craigyjp/Poly-Zero-8-voice-Polysynth/Photos/20240305_211138.jpg

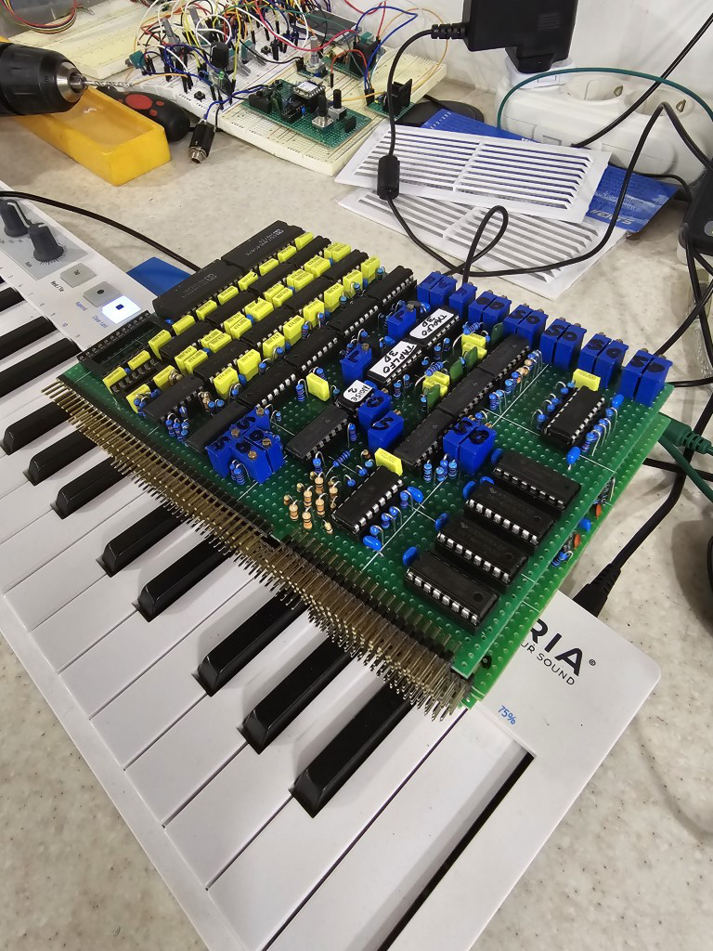
Photos/20240305_211138.jpg
