craigyjp/Poly-Zero-8-voice-Polysynth/Photos/20240305_211143.jpg

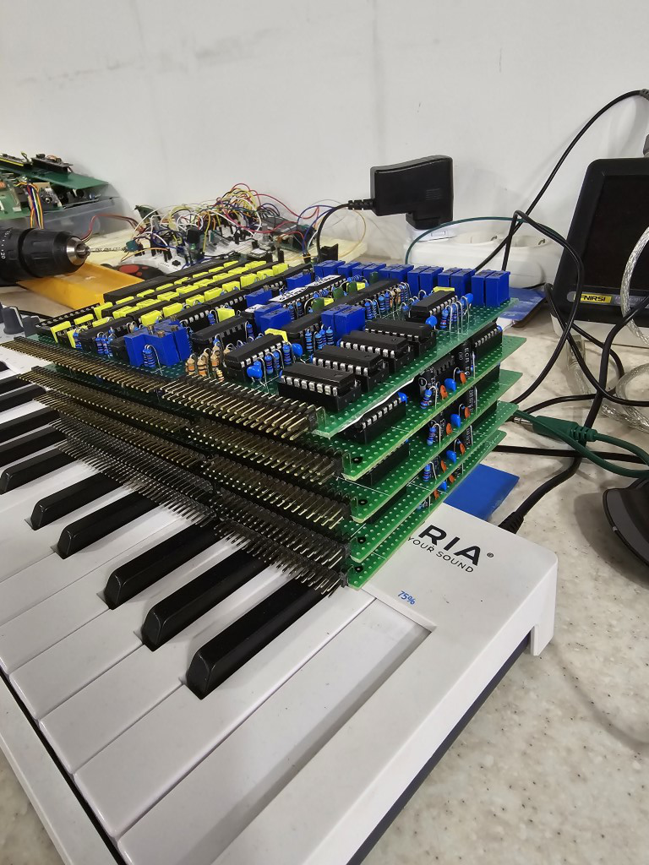
Photos/20240305_211143.jpg
