craigyjp/Poly-Zero-8-voice-Polysynth/Photos/20240305_211212.jpg

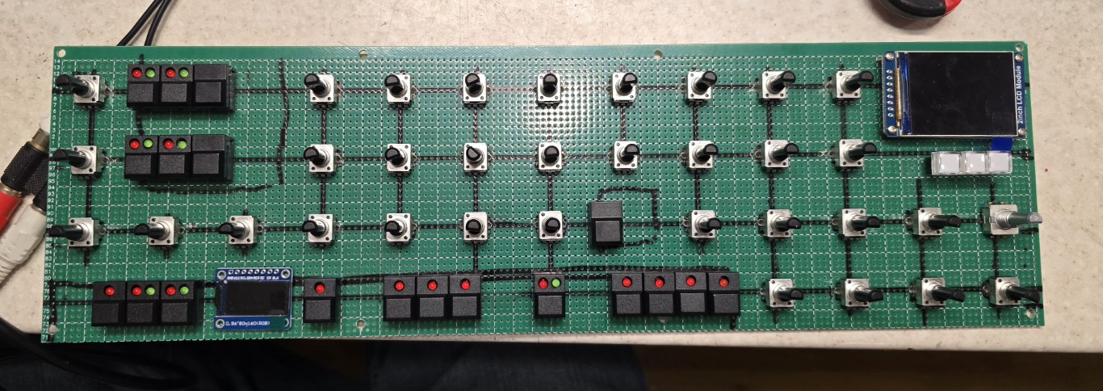
Photos/20240305_211212.jpg
