craigyjp/Poly-Zero-8-voice-Polysynth/Photos/20240306_220125.jpg

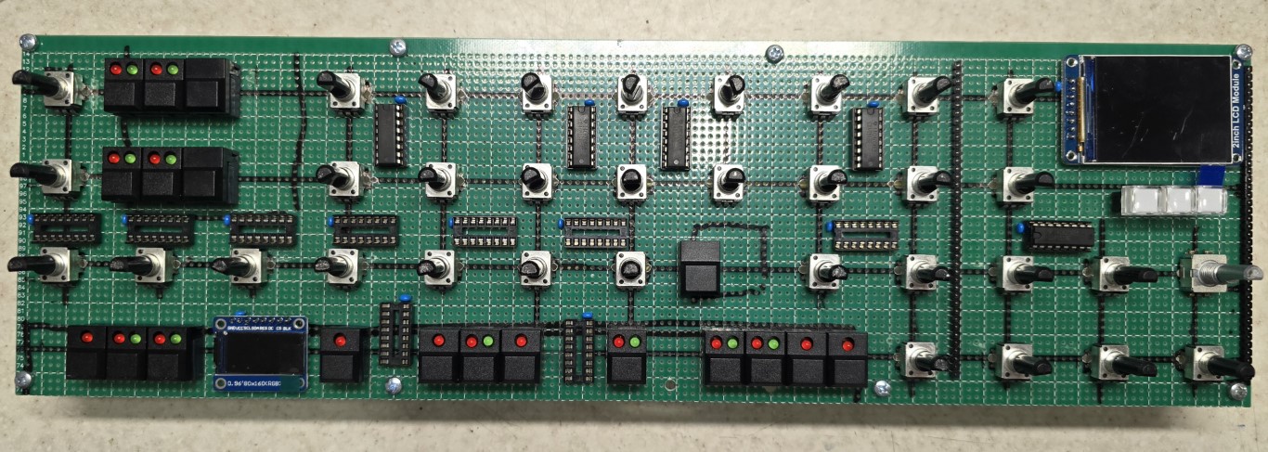
Photos/20240306_220125.jpg
