craigyjp/Poly-Zero-8-voice-Polysynth/Photos/20240310_184923.jpg

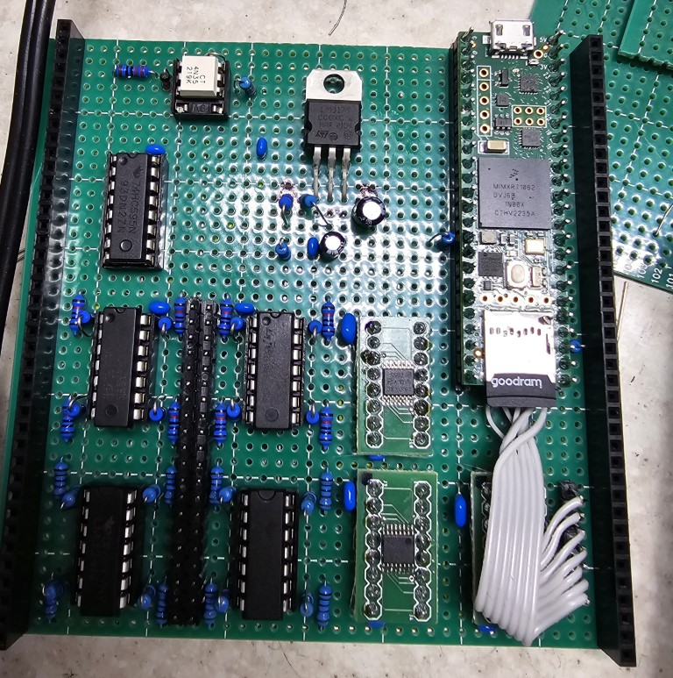
Photos/20240310_184923.jpg
