craigyjp/Poly-Zero-8-voice-Polysynth/Photos/20240310_185404.jpg

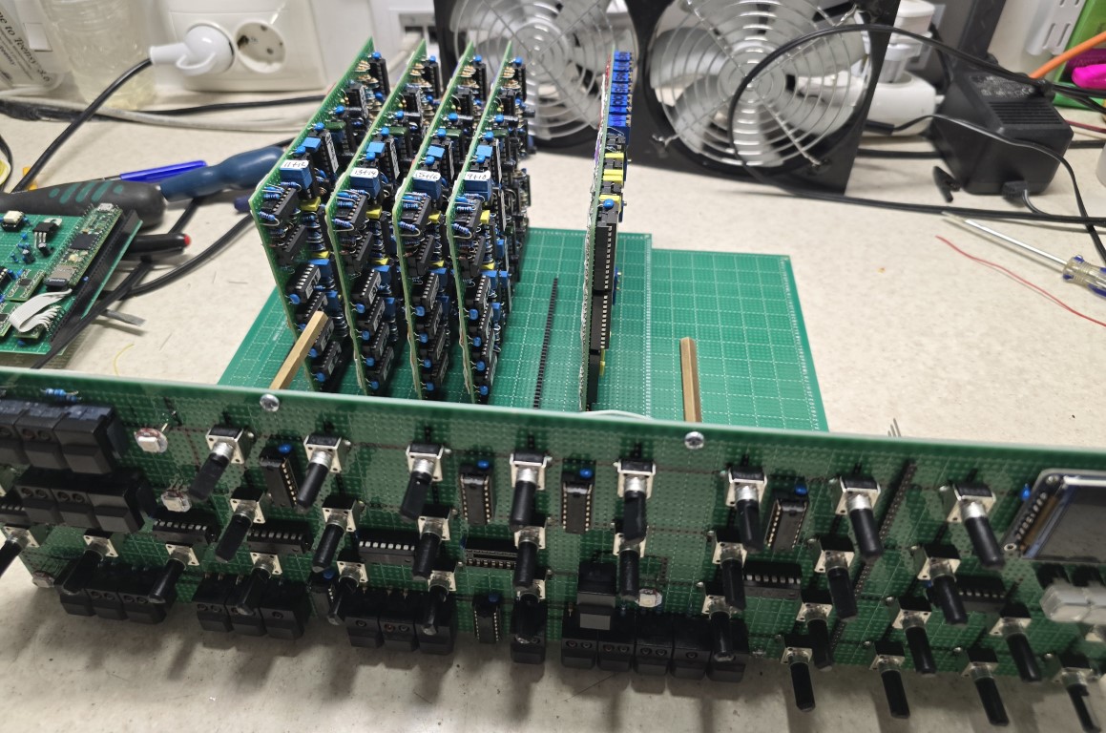
Photos/20240310_185404.jpg
