craigyjp/Poly-Zero-8-voice-Polysynth/Photos/20240312_125551.jpg

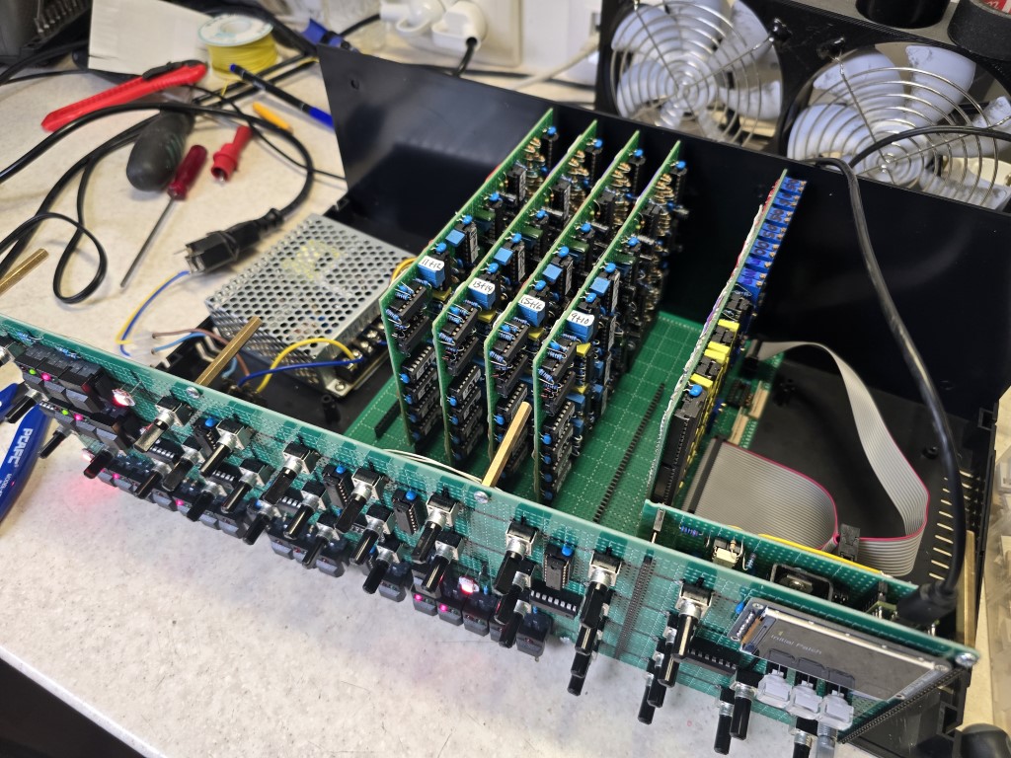
Photos/20240312_125551.jpg
