craigyjp/Poly-Zero-8-voice-Polysynth/Photos/20240313_165845.jpg

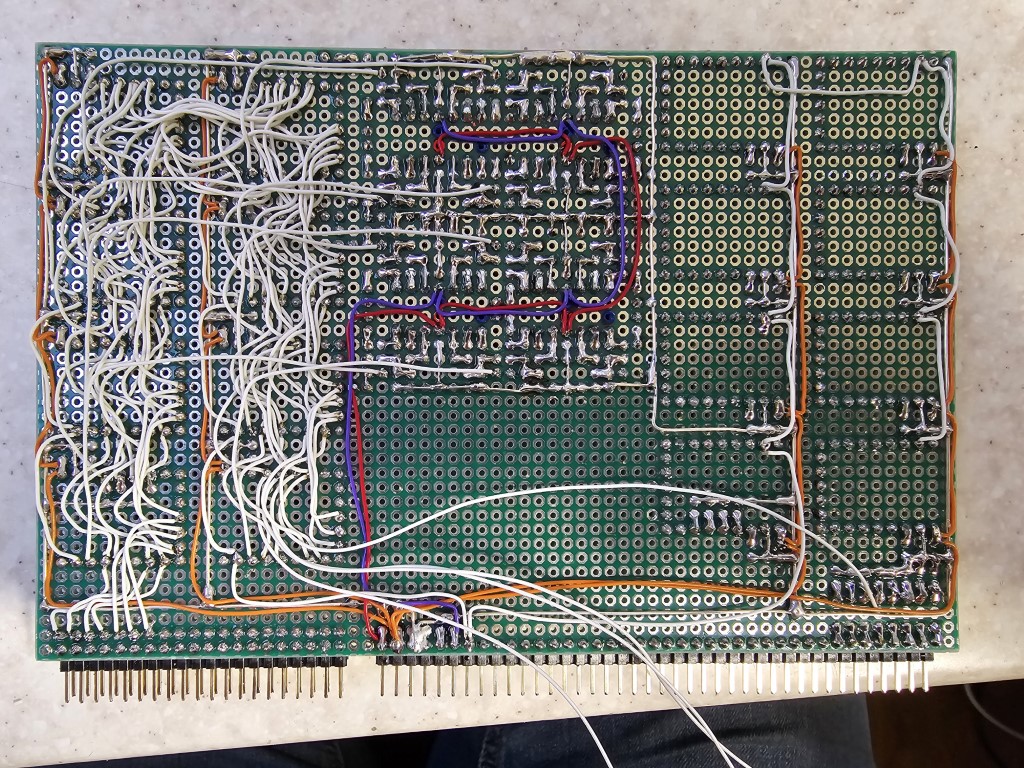
Photos/20240313_165845.jpg
