craigyjp/Poly-Zero-8-voice-Polysynth/Photos/20240313_225103.jpg

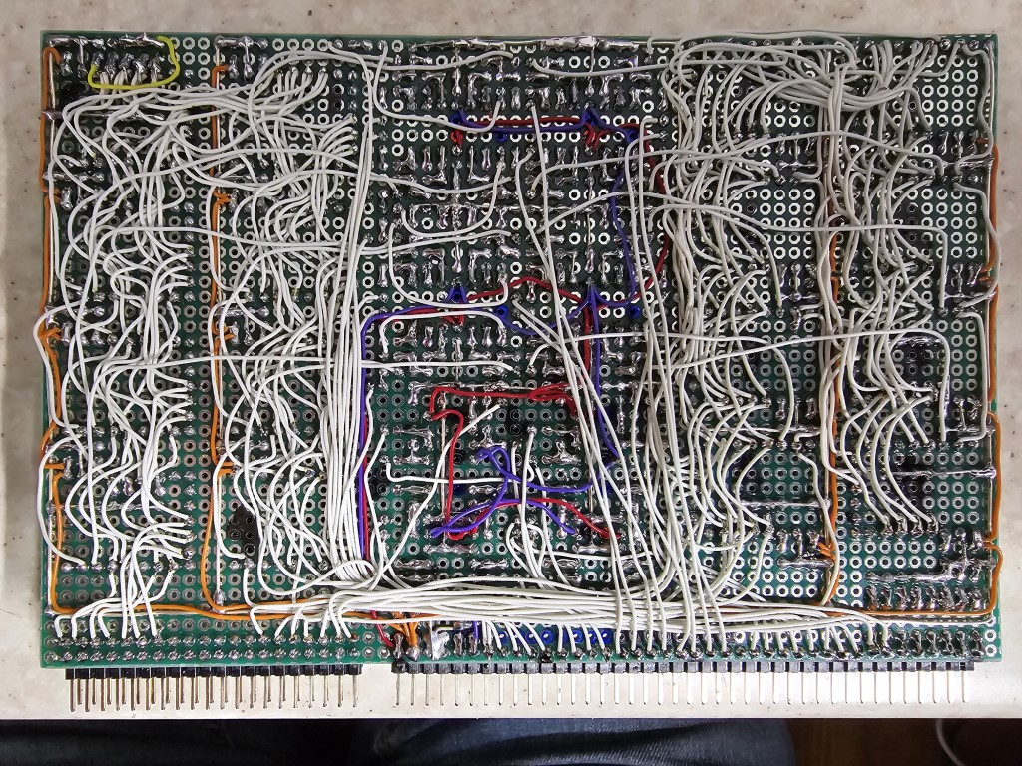
Photos/20240313_225103.jpg
