craigyjp/Poly-Zero-8-voice-Polysynth/Photos/20240326_214050.jpg

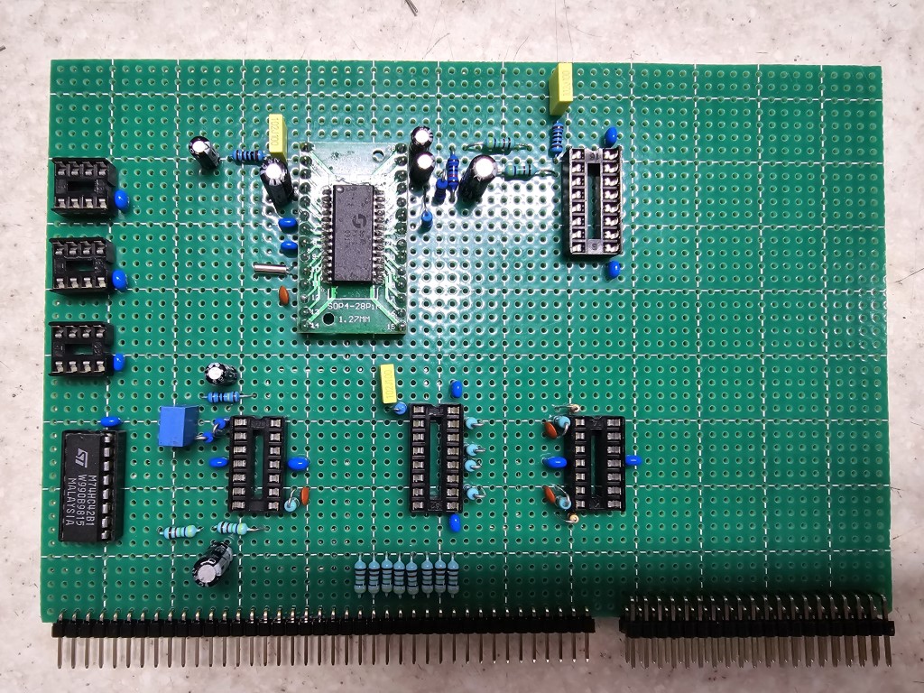
Photos/20240326_214050.jpg
