craigyjp/Poly-Zero-8-voice-Polysynth/Photos/20240331_192204.jpg

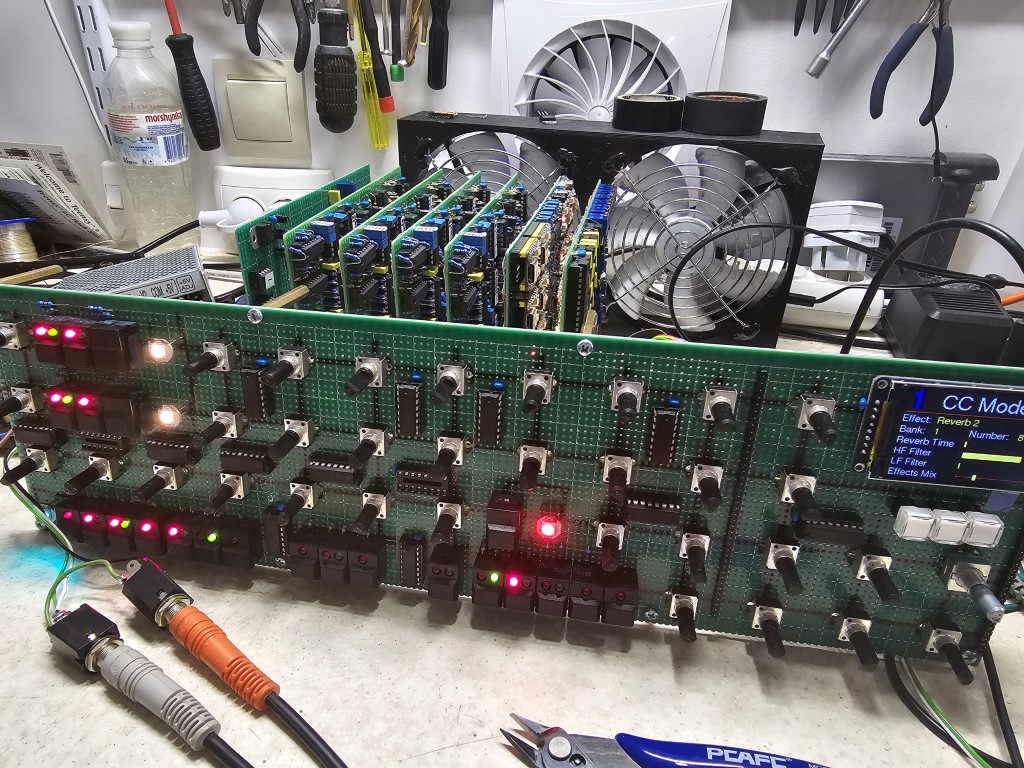
Photos/20240331_192204.jpg
