craigyjp/Poly-Zero-8-voice-Polysynth/Photos/20240331_193349.jpg

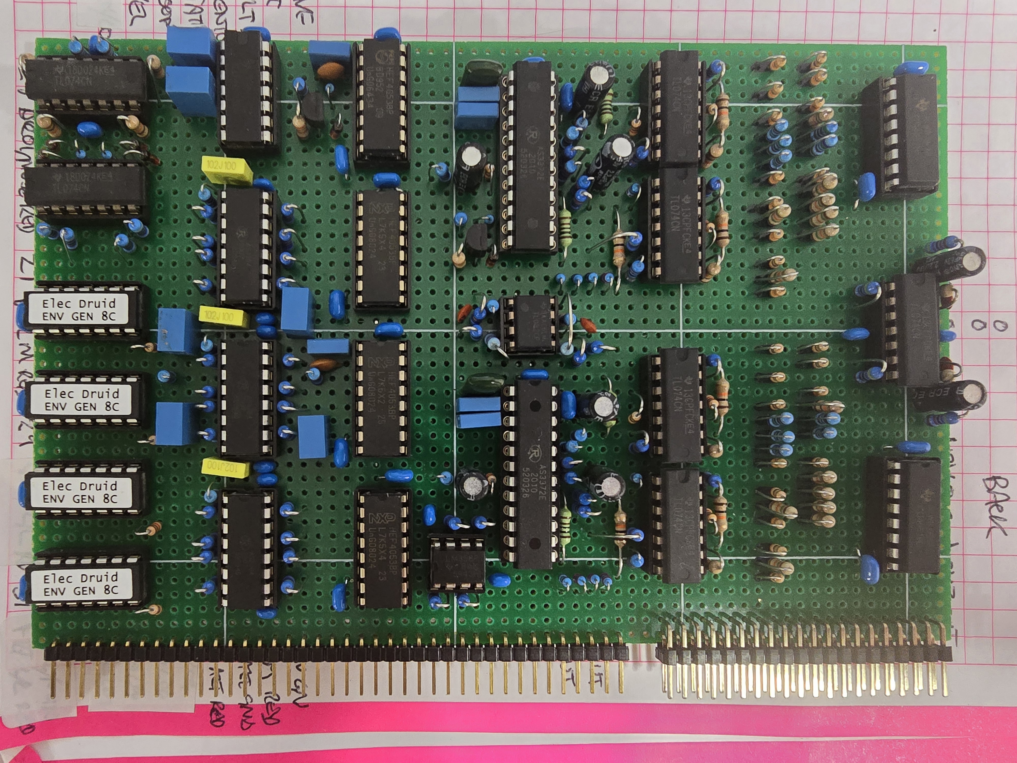
Photos/20240331_193349.jpg
