craigyjp/Poly-Zero-8-voice-Polysynth/Photos/20240331_193359.jpg

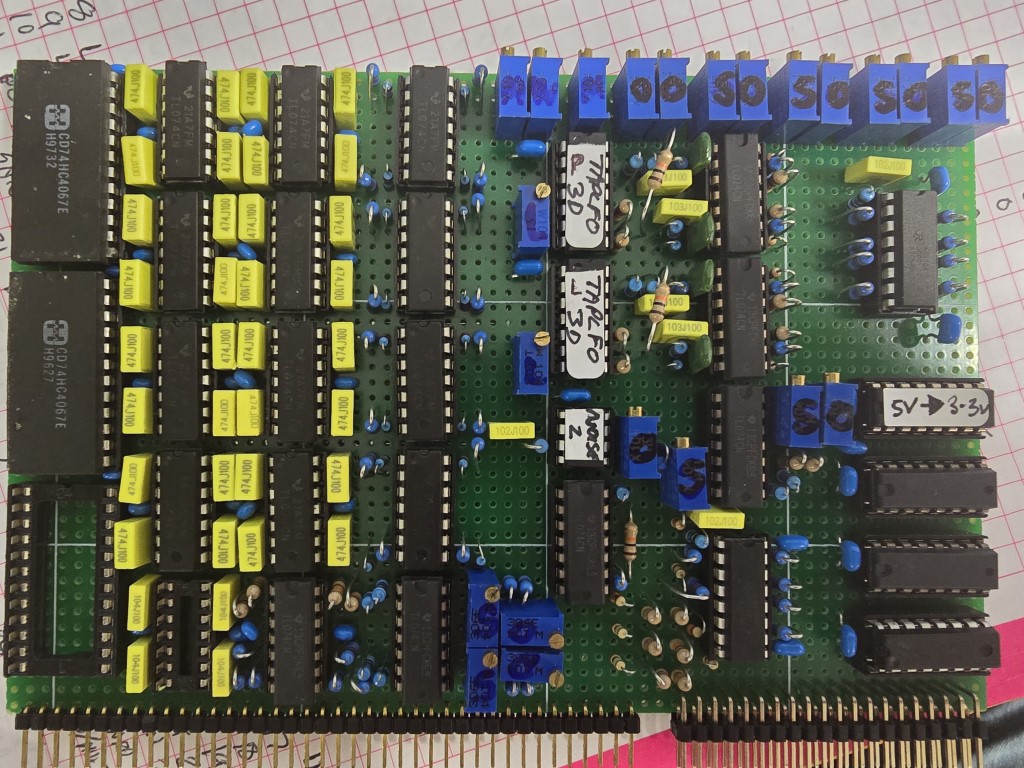
Photos/20240331_193359.jpg
