craigyjp/Poly-Zero-8-voice-Polysynth/Photos/synth2.jpg

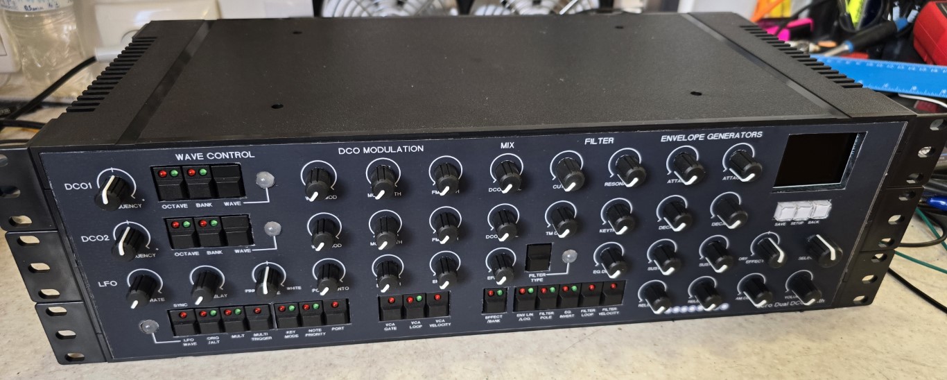
Photos/synth2.jpg
