craigyjp/Poly-Zero-8-voice-Polysynth/(threads)

Thread 1 (2024-05-25):

More pictures and PCB available?

spotlesscoder, 2024-05-25:
Hi,

do you have more pictures of the inner life of the device?
Looks really promising - I would love to build one for myself - do you have gerber files for the PCB(s) inside?

craigyjp, 2024-05-25:
Hi, I don't have gerbers because it's on proto boards and not PCB's, all hand wired for the 7 cards and the mother board.

craigyjp, 2024-05-25:
I've just added some photos

craigyjp, 2024-05-25:
I hope thats enough info

spotlesscoder, 2024-05-25:
Holy hell that must have been a lot of work :O

Thanks for sharing this, loving it :)

Closed 2024-05-25.
