craigyjp/Poly-Zero-8-voice-Polysynth/Schematics/Zero_DCO_Board.pdf

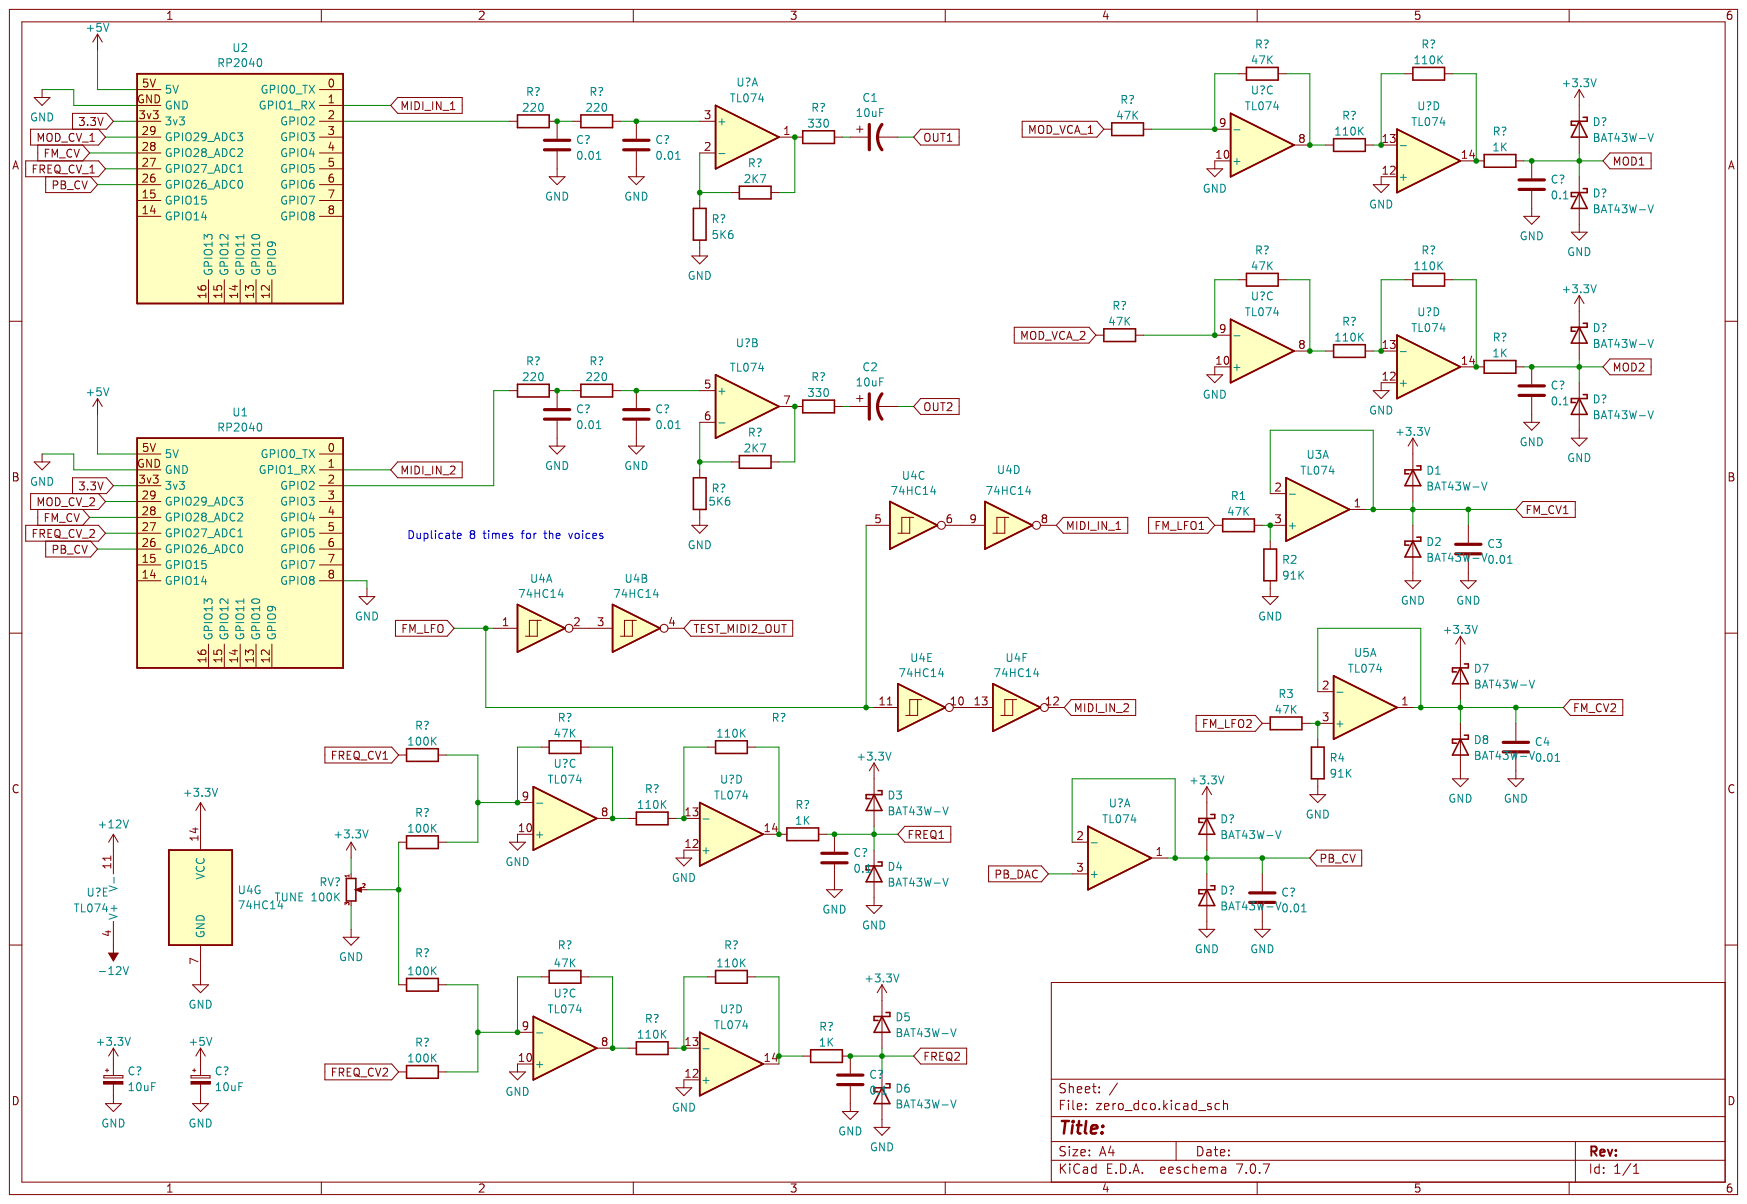
[picture p17: page 1]
