craigyjp/Poly-Zero-8-voice-Polysynth/Schematics/DAC_Demux.pdf

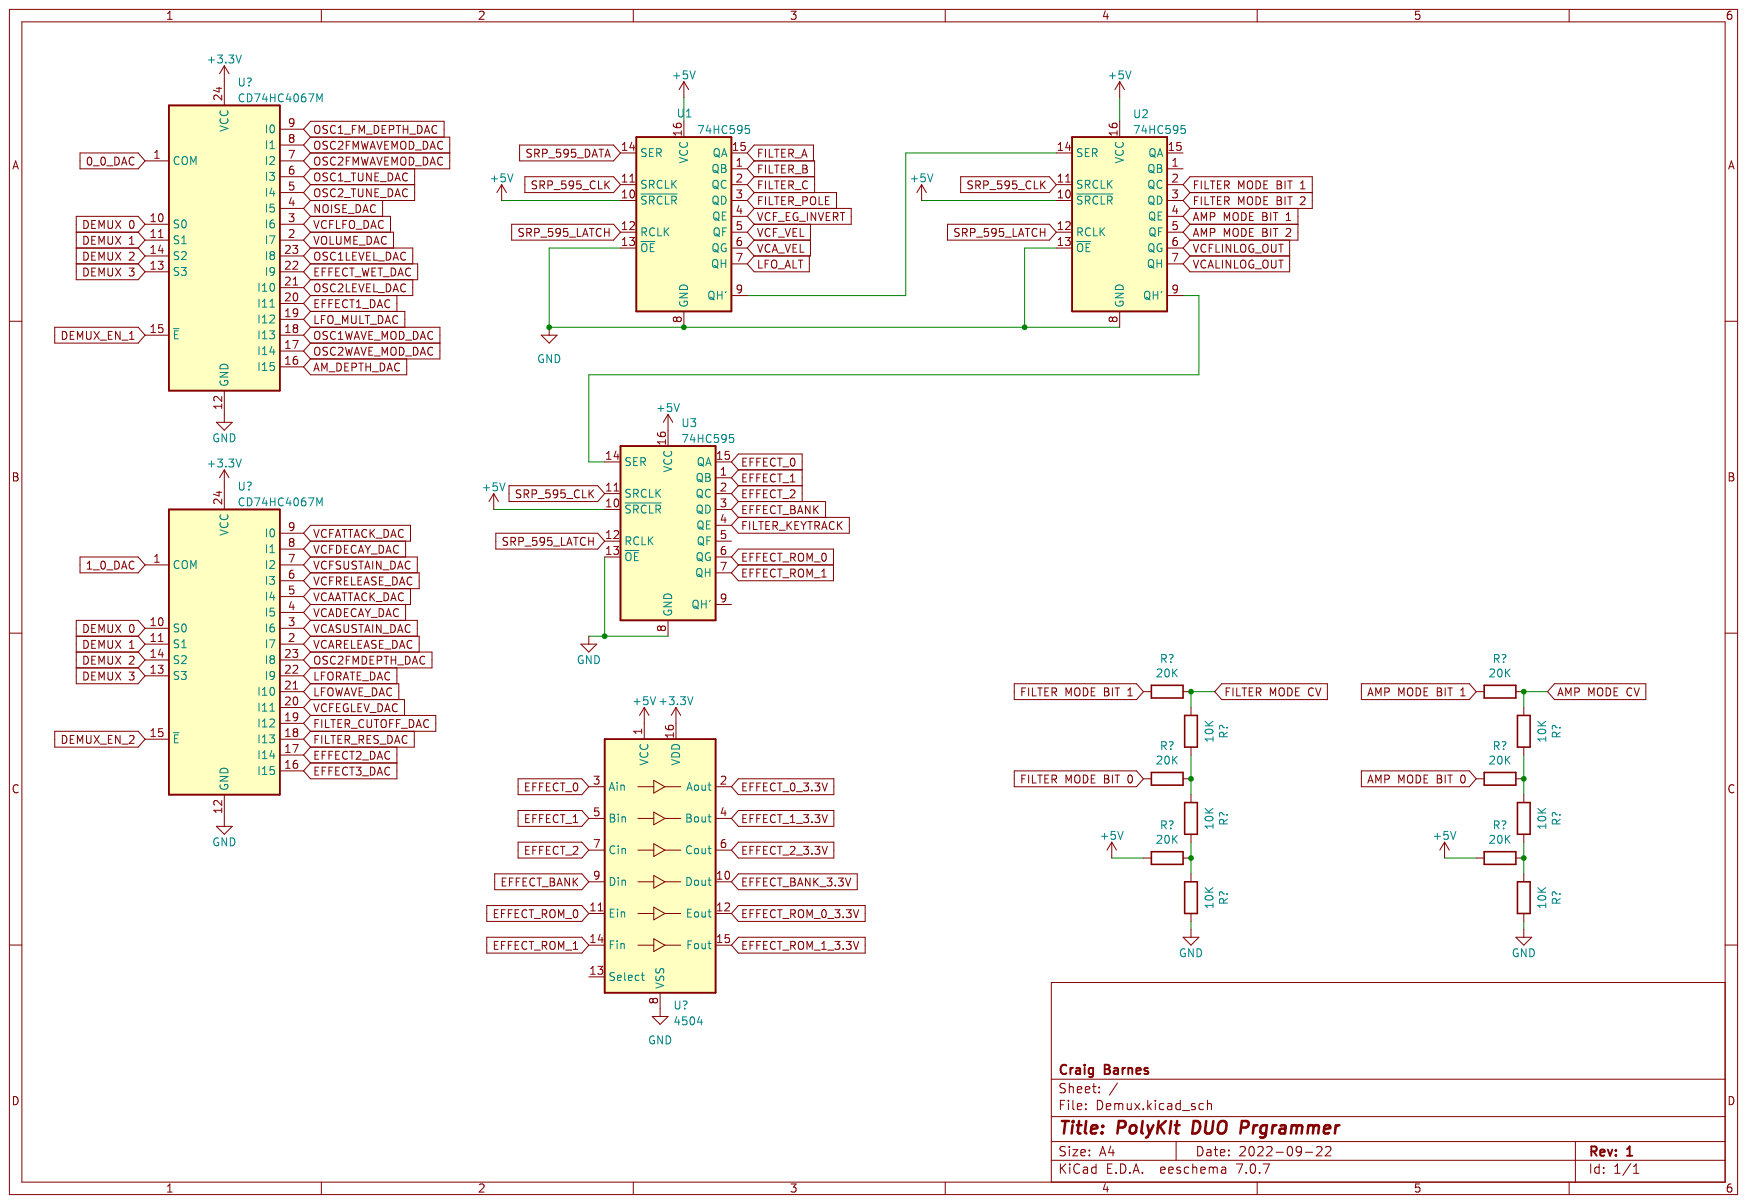
[picture p18: page 1]
