craigyjp/Poly-Zero-8-voice-Polysynth/Schematics/Effects_Board.pdf

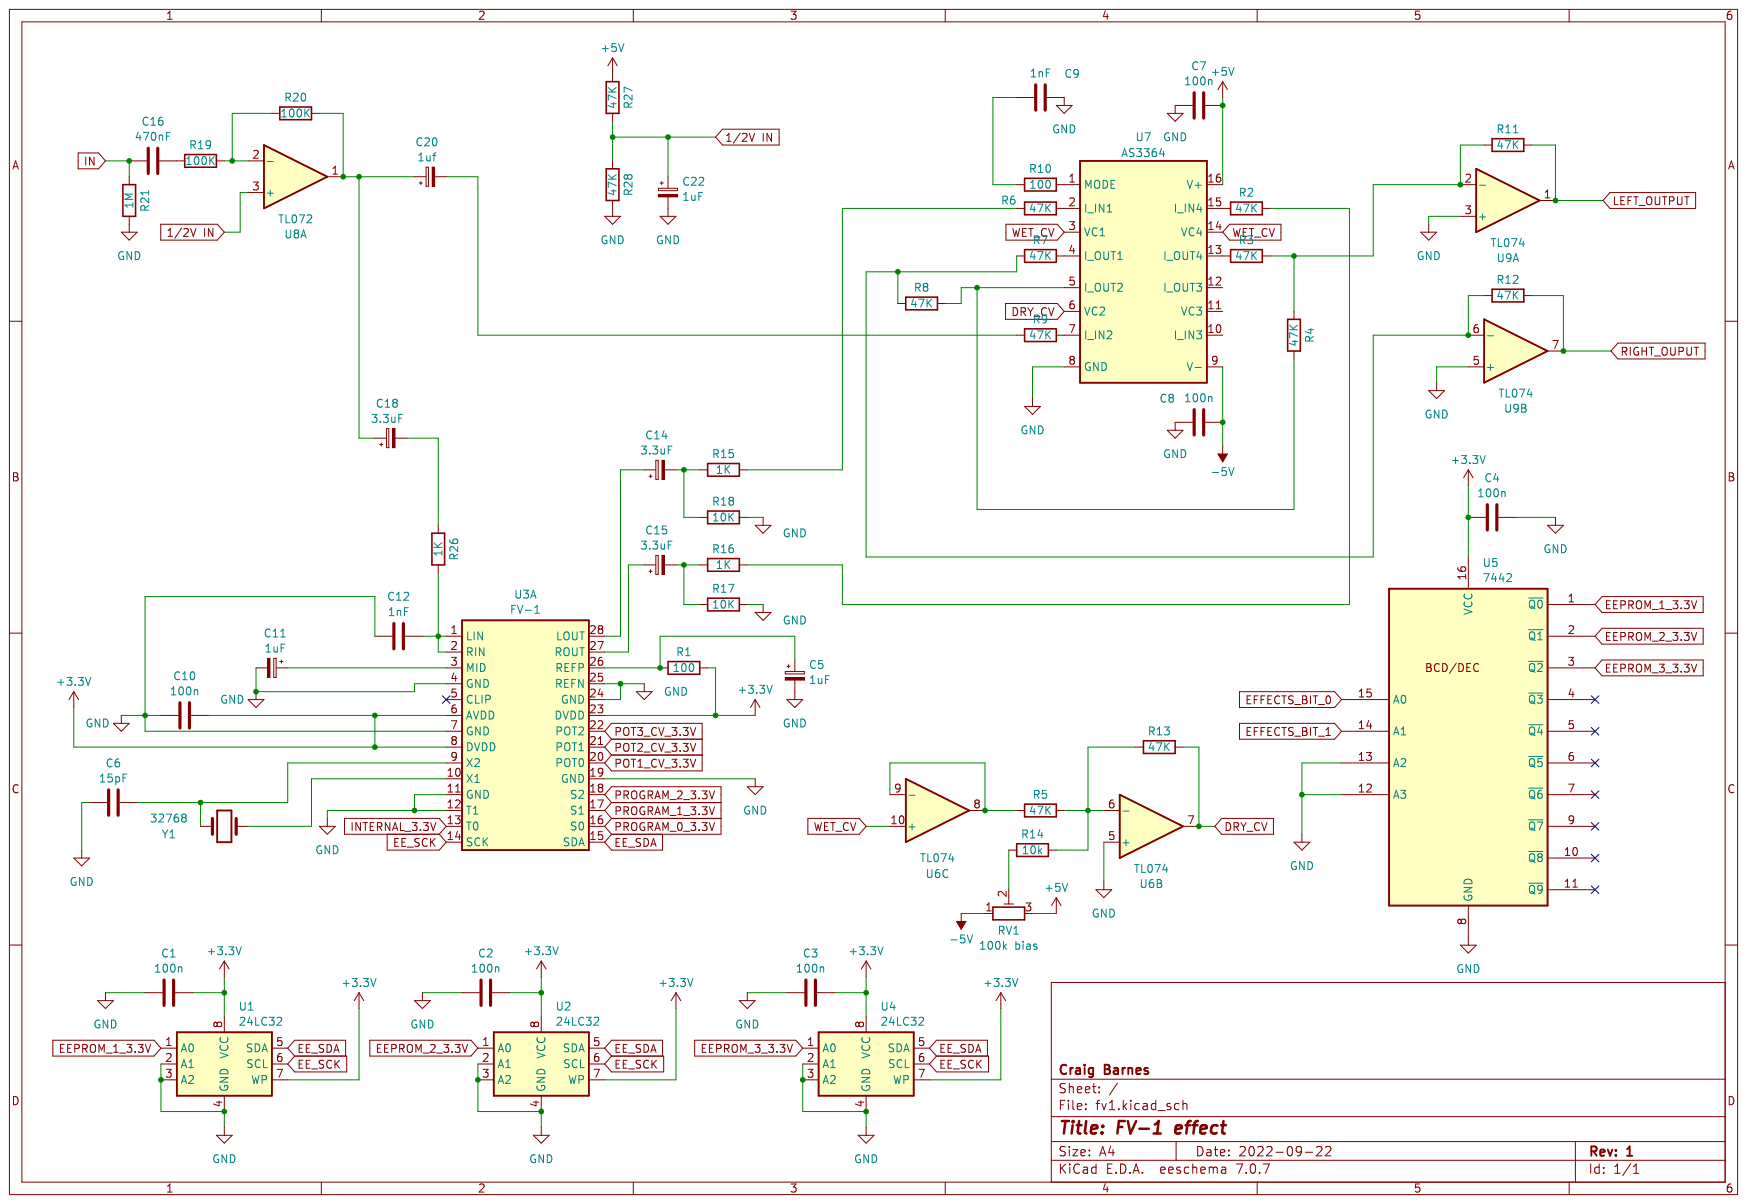
[picture p19: page 1]
