craigyjp/Poly-Zero-8-voice-Polysynth/Schematics/Final_VCA.pdf

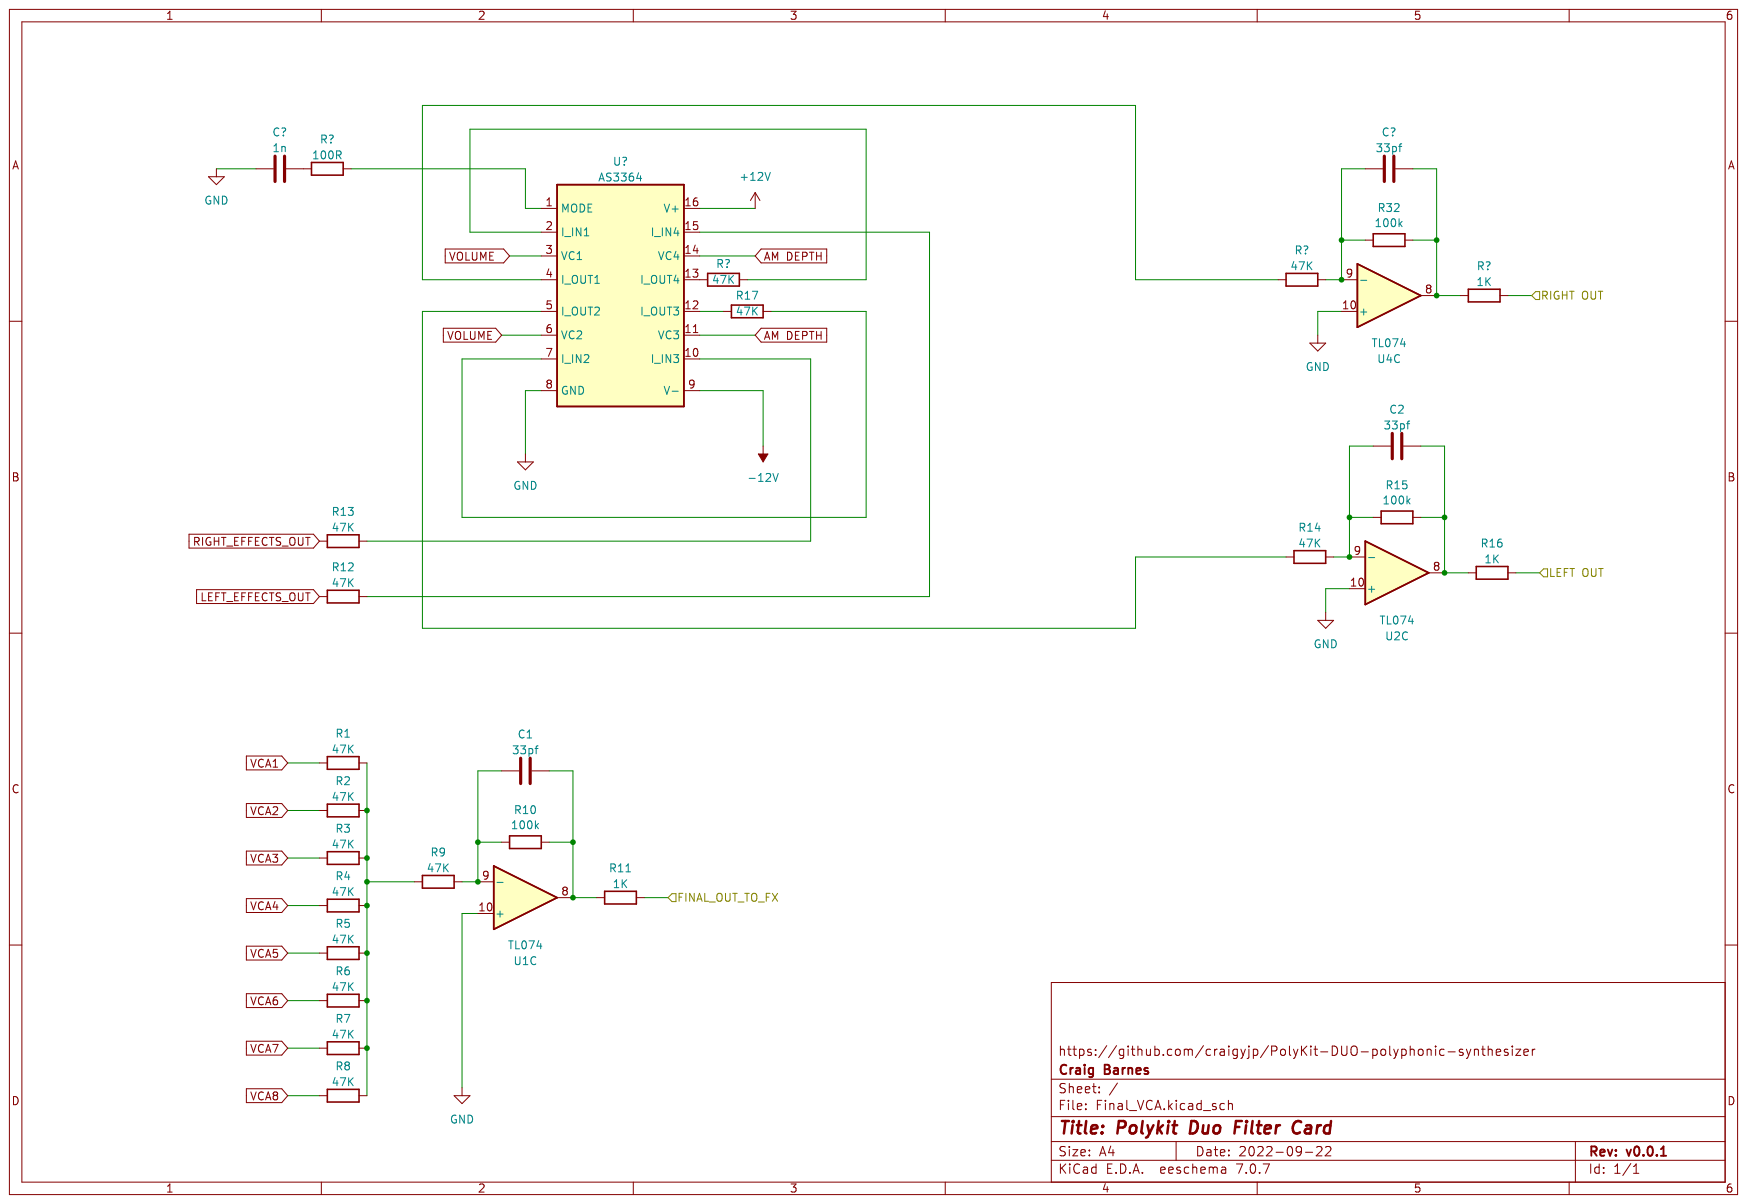
[picture p20: page 1]
