craigyjp/Poly-Zero-8-voice-Polysynth/Schematics/FrontPanel_pots.pdf

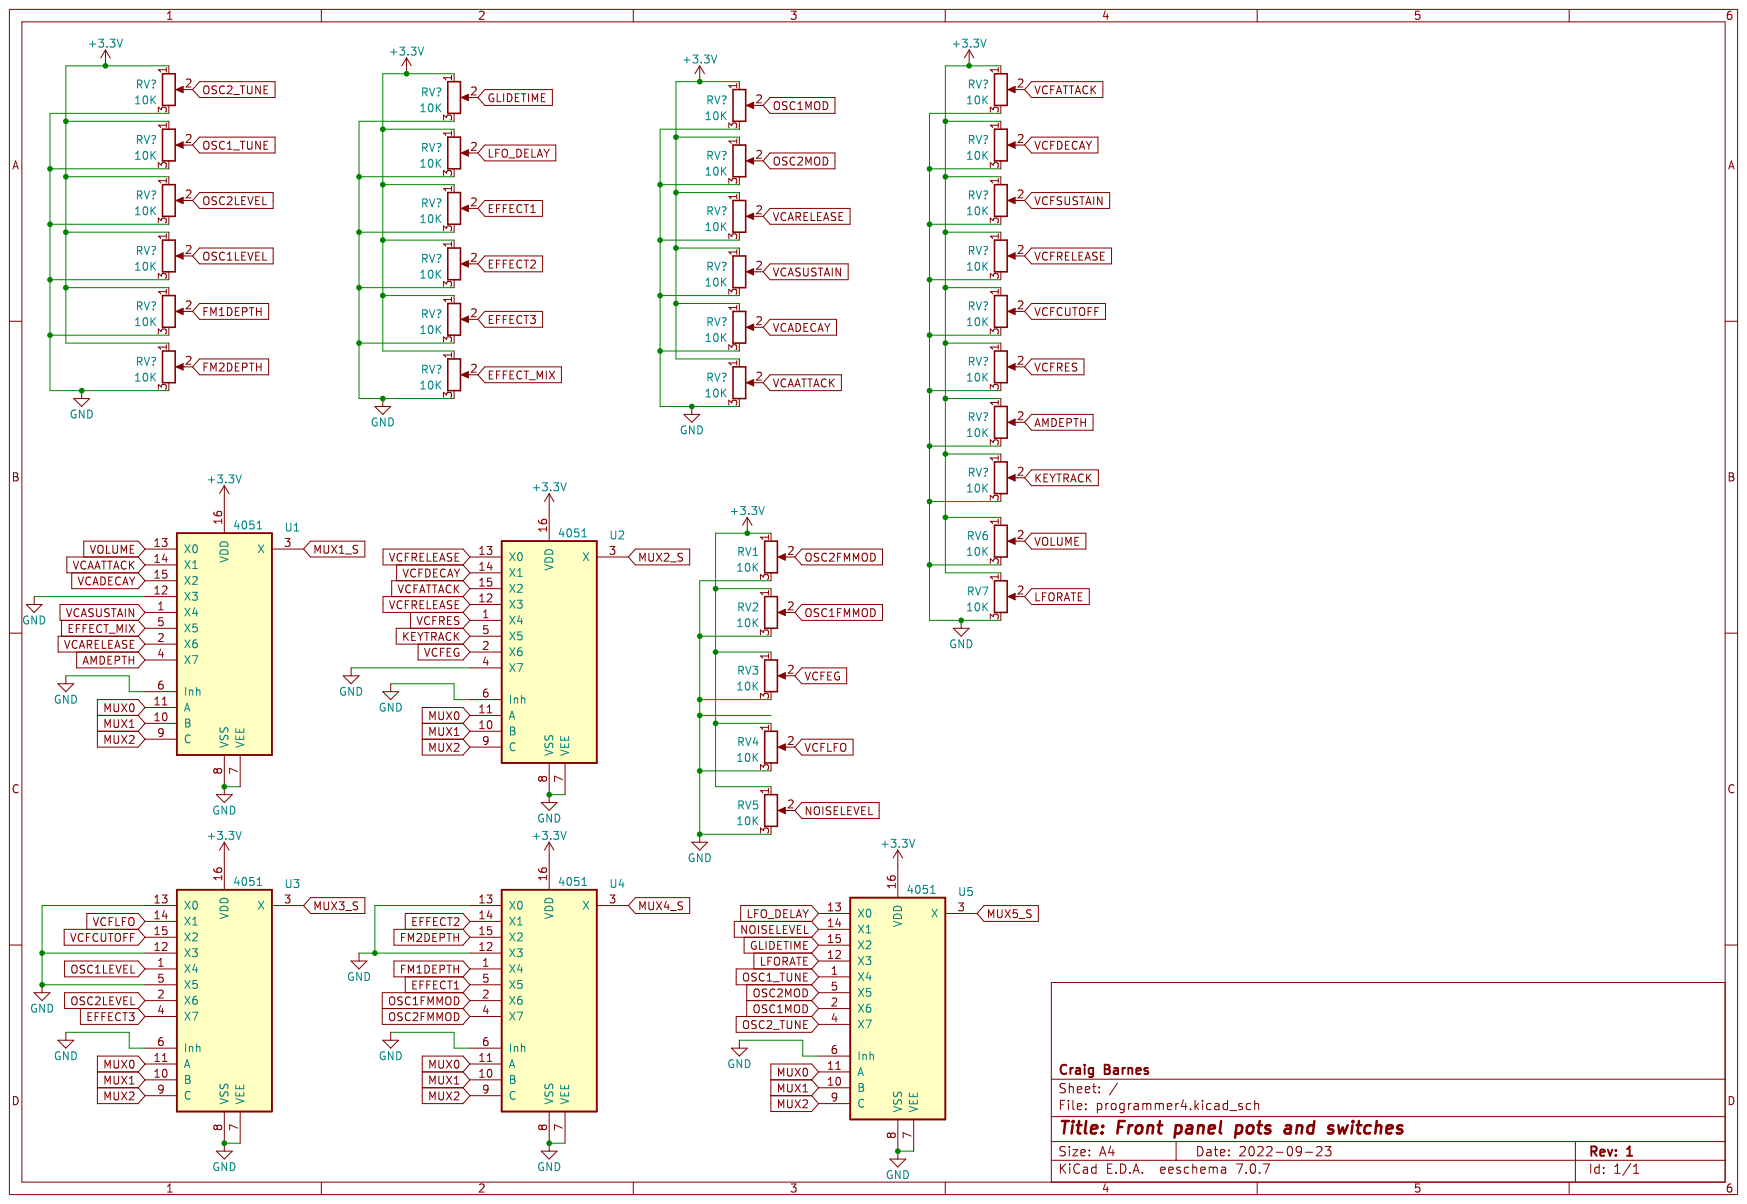
[picture p21: page 1]
