craigyjp/Poly-Zero-8-voice-Polysynth/Schematics/FrontPanelButtons.pdf

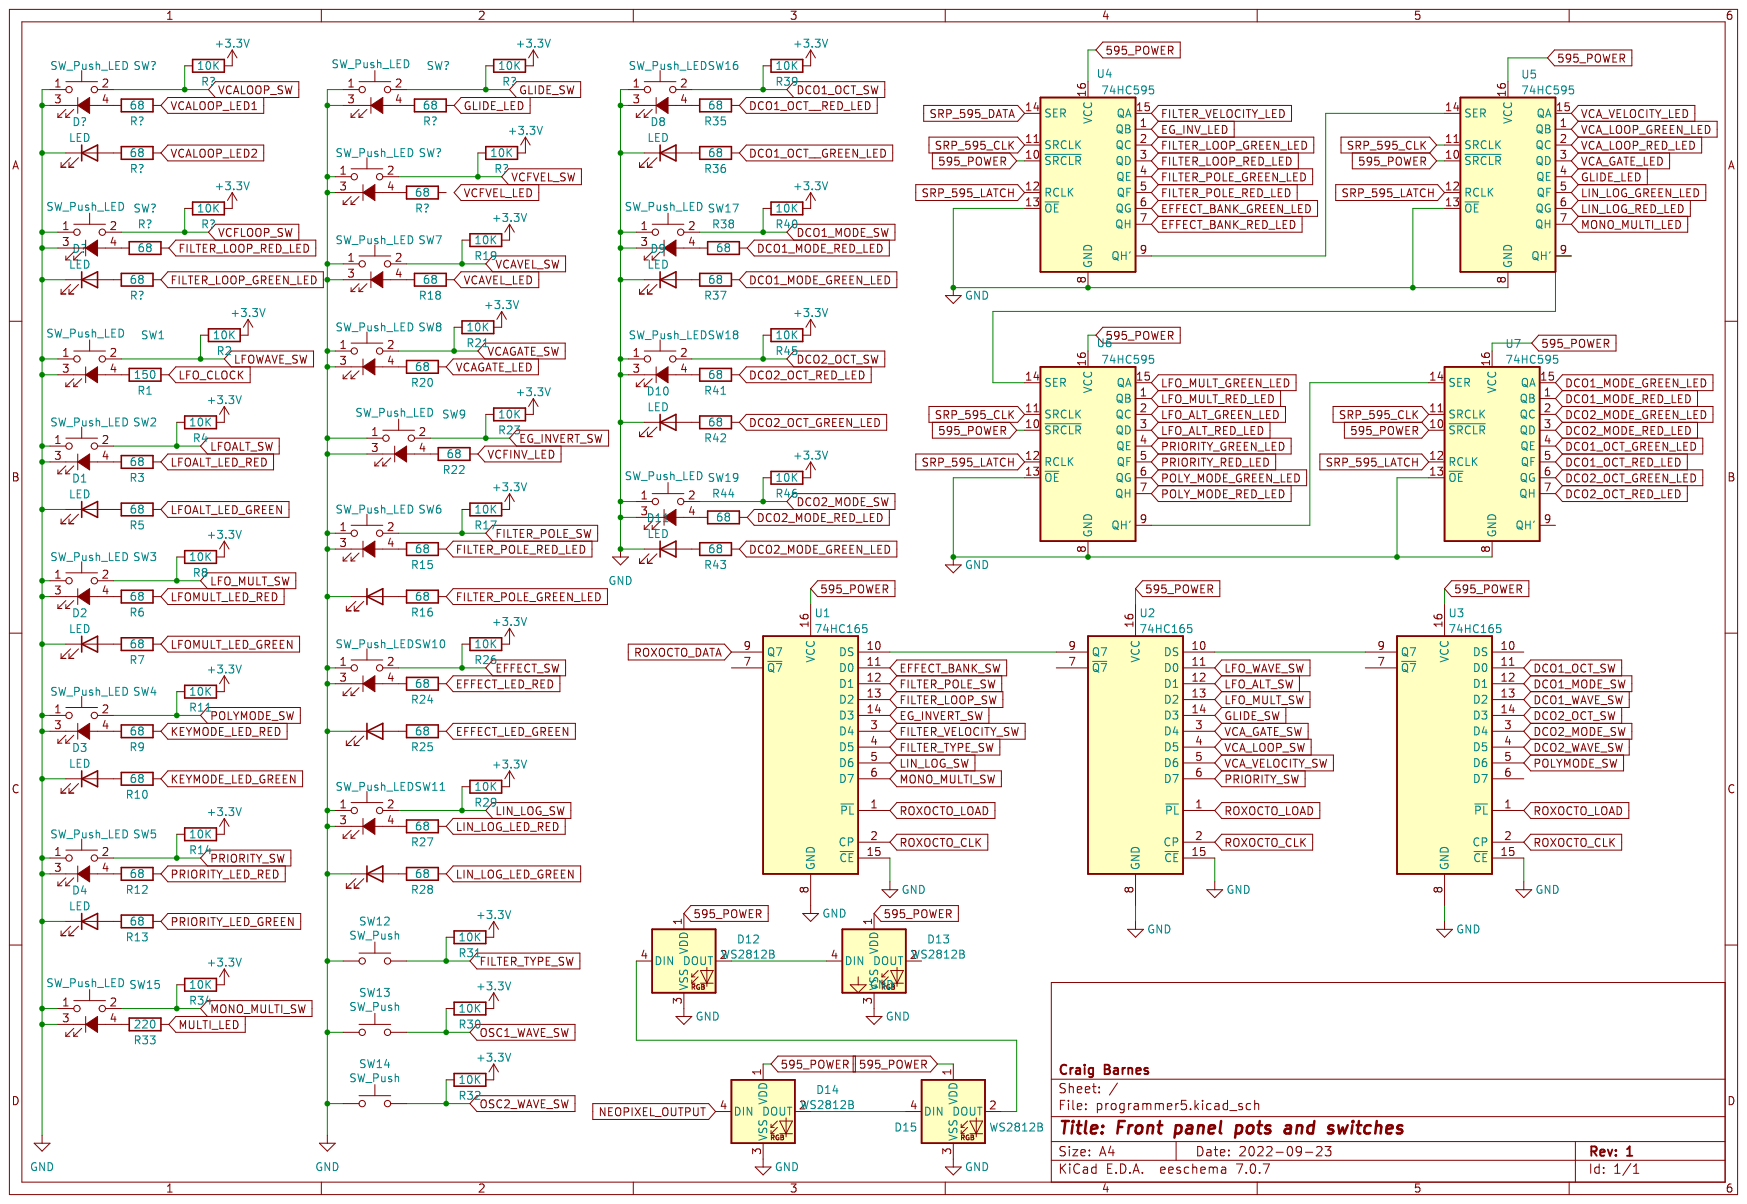
[picture p22: page 1]
