craigyjp/Poly-Zero-8-voice-Polysynth/Schematics/Level_conversion.pdf

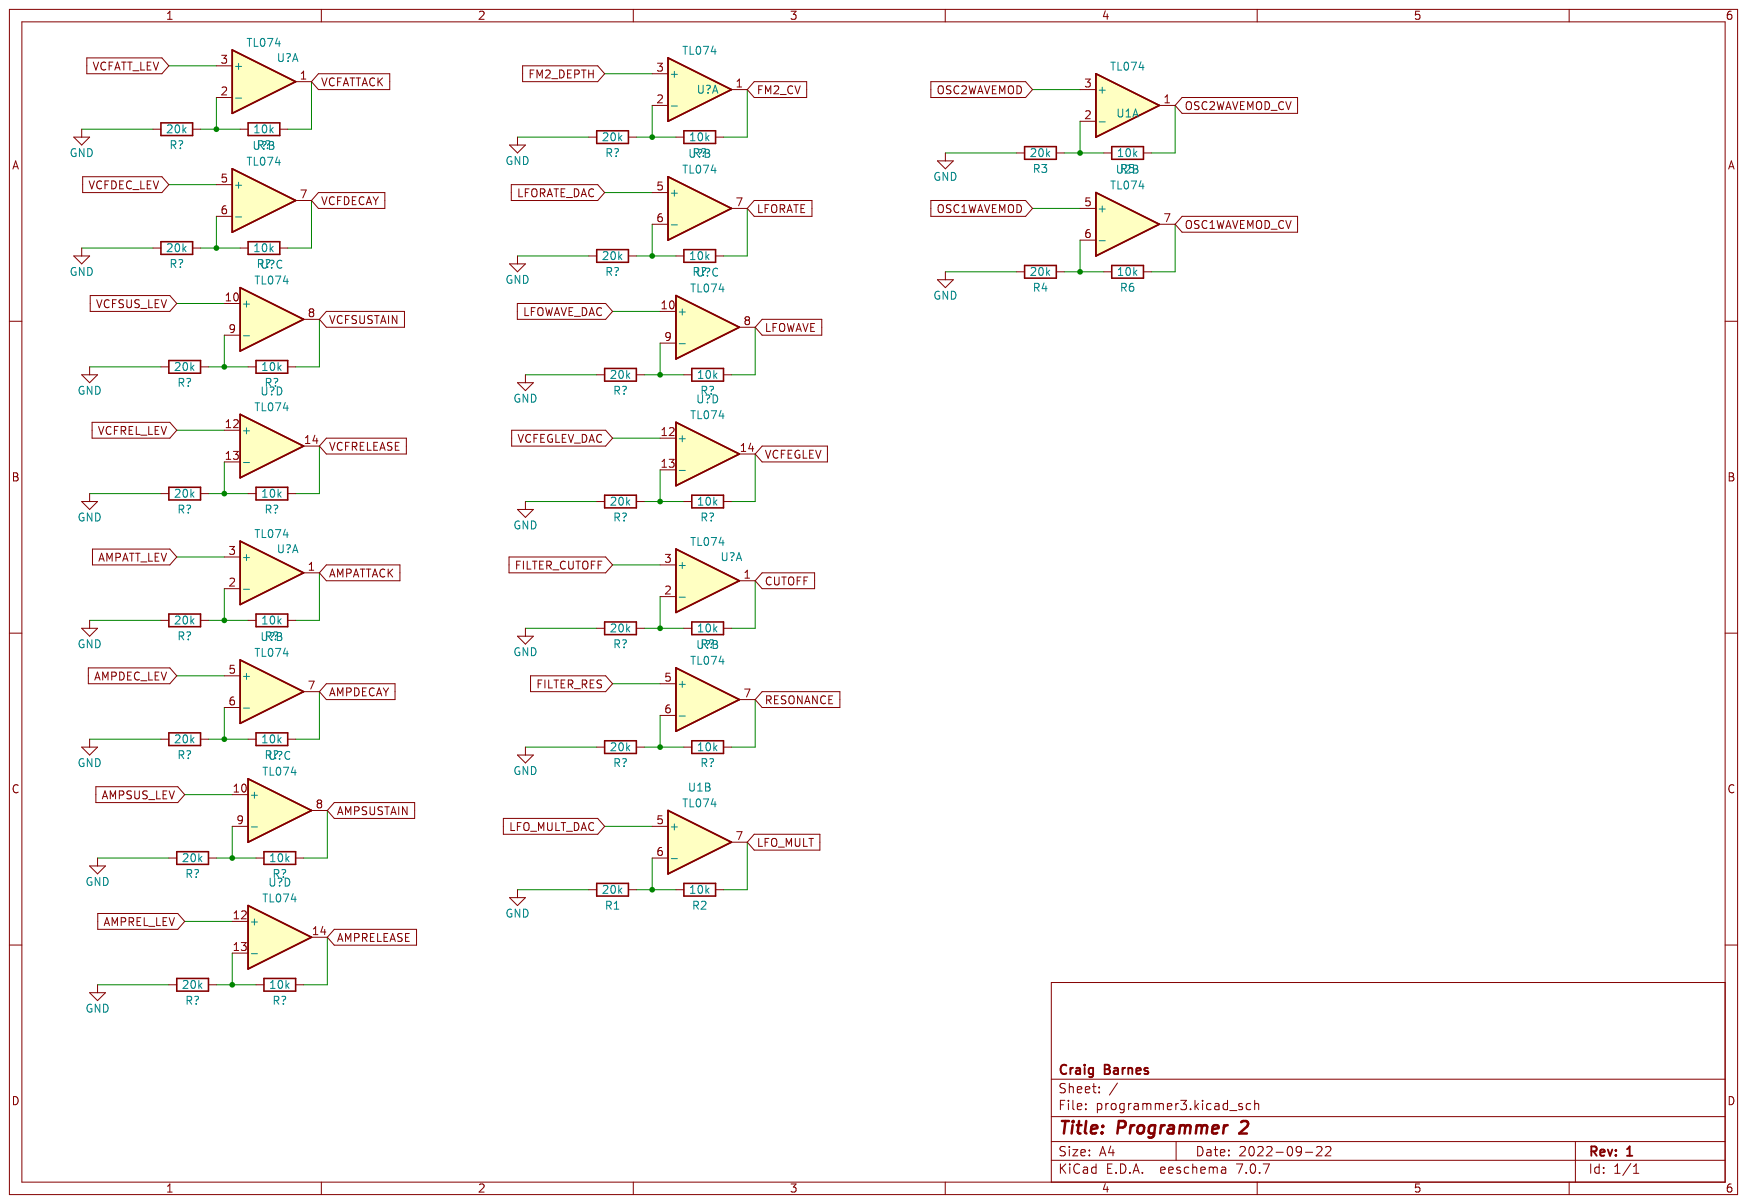
[picture p23: page 1]
