craigyjp/Poly-Zero-8-voice-Polysynth/Schematics/Sample_And_Hold.pdf

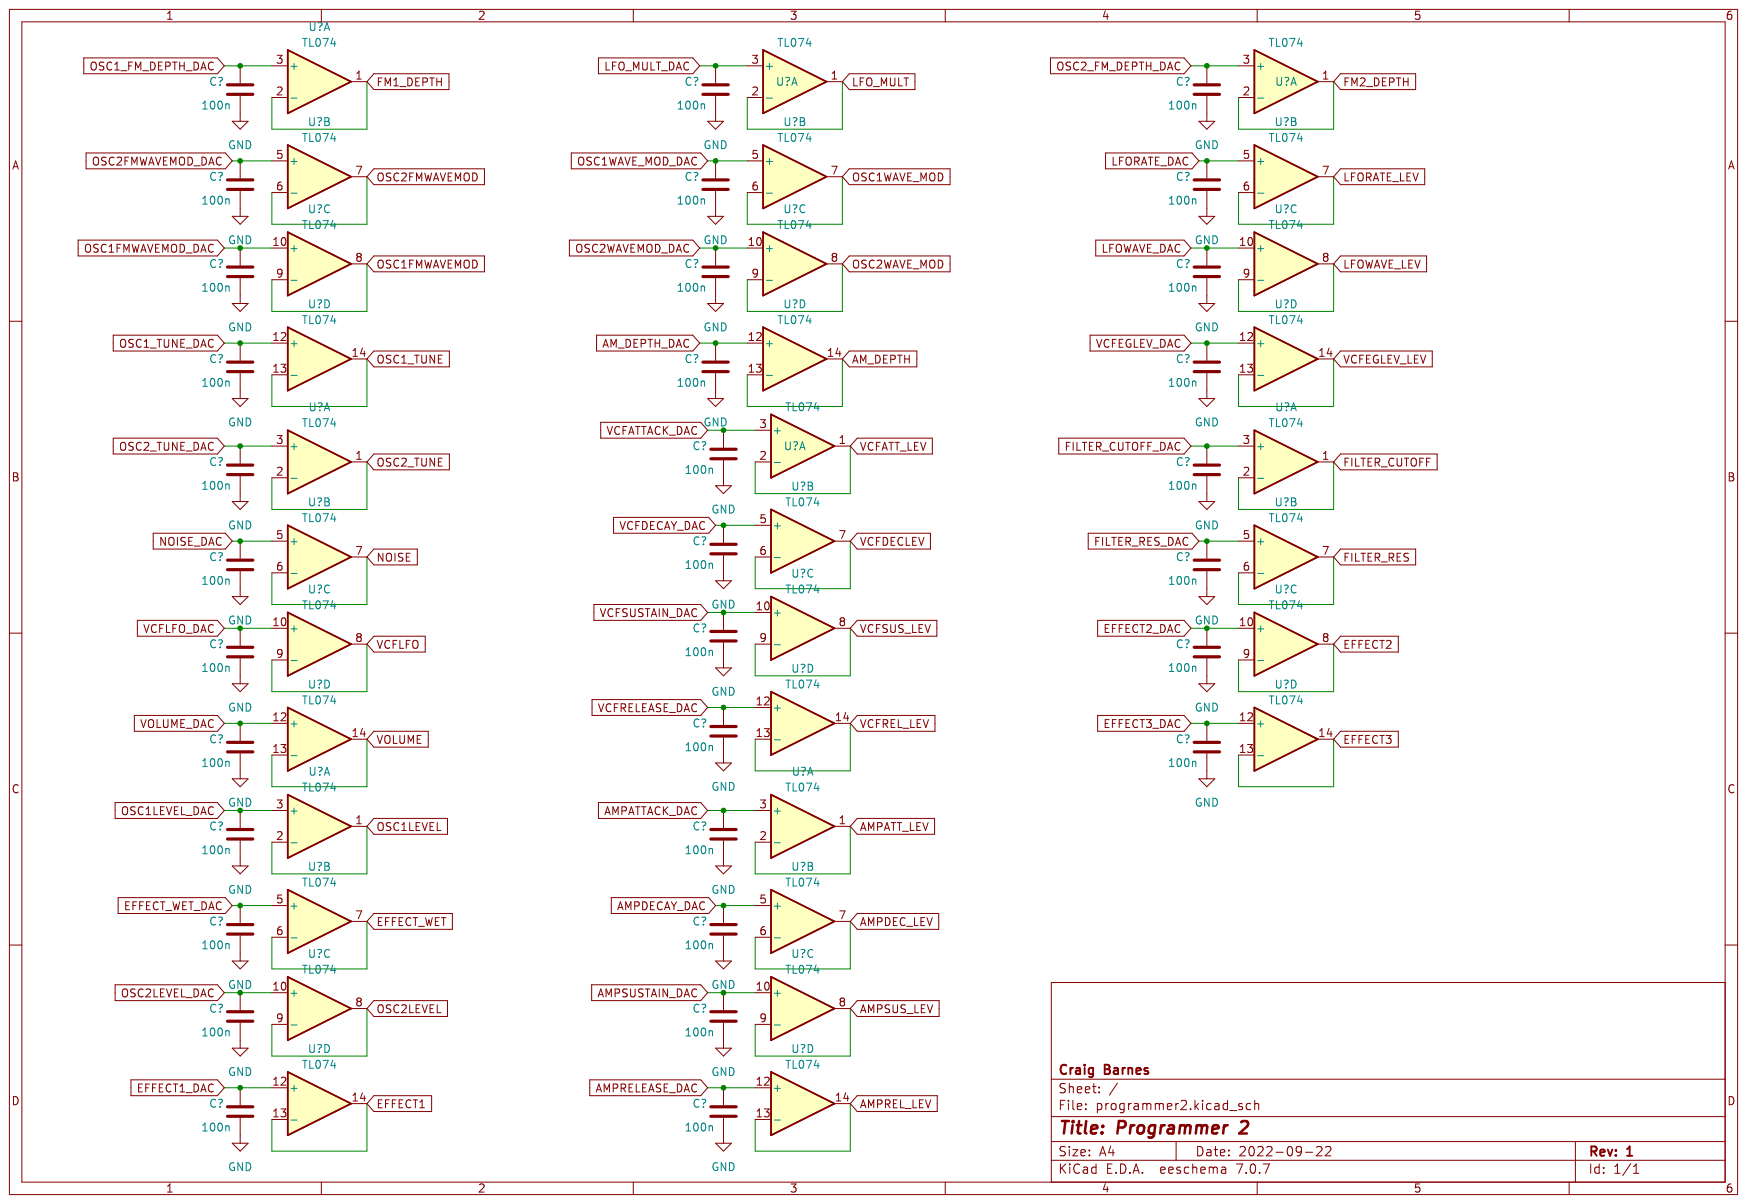
[picture p24: page 1]
