craigyjp/Poly-Zero-8-voice-Polysynth/Schematics/AS3372E.pdf

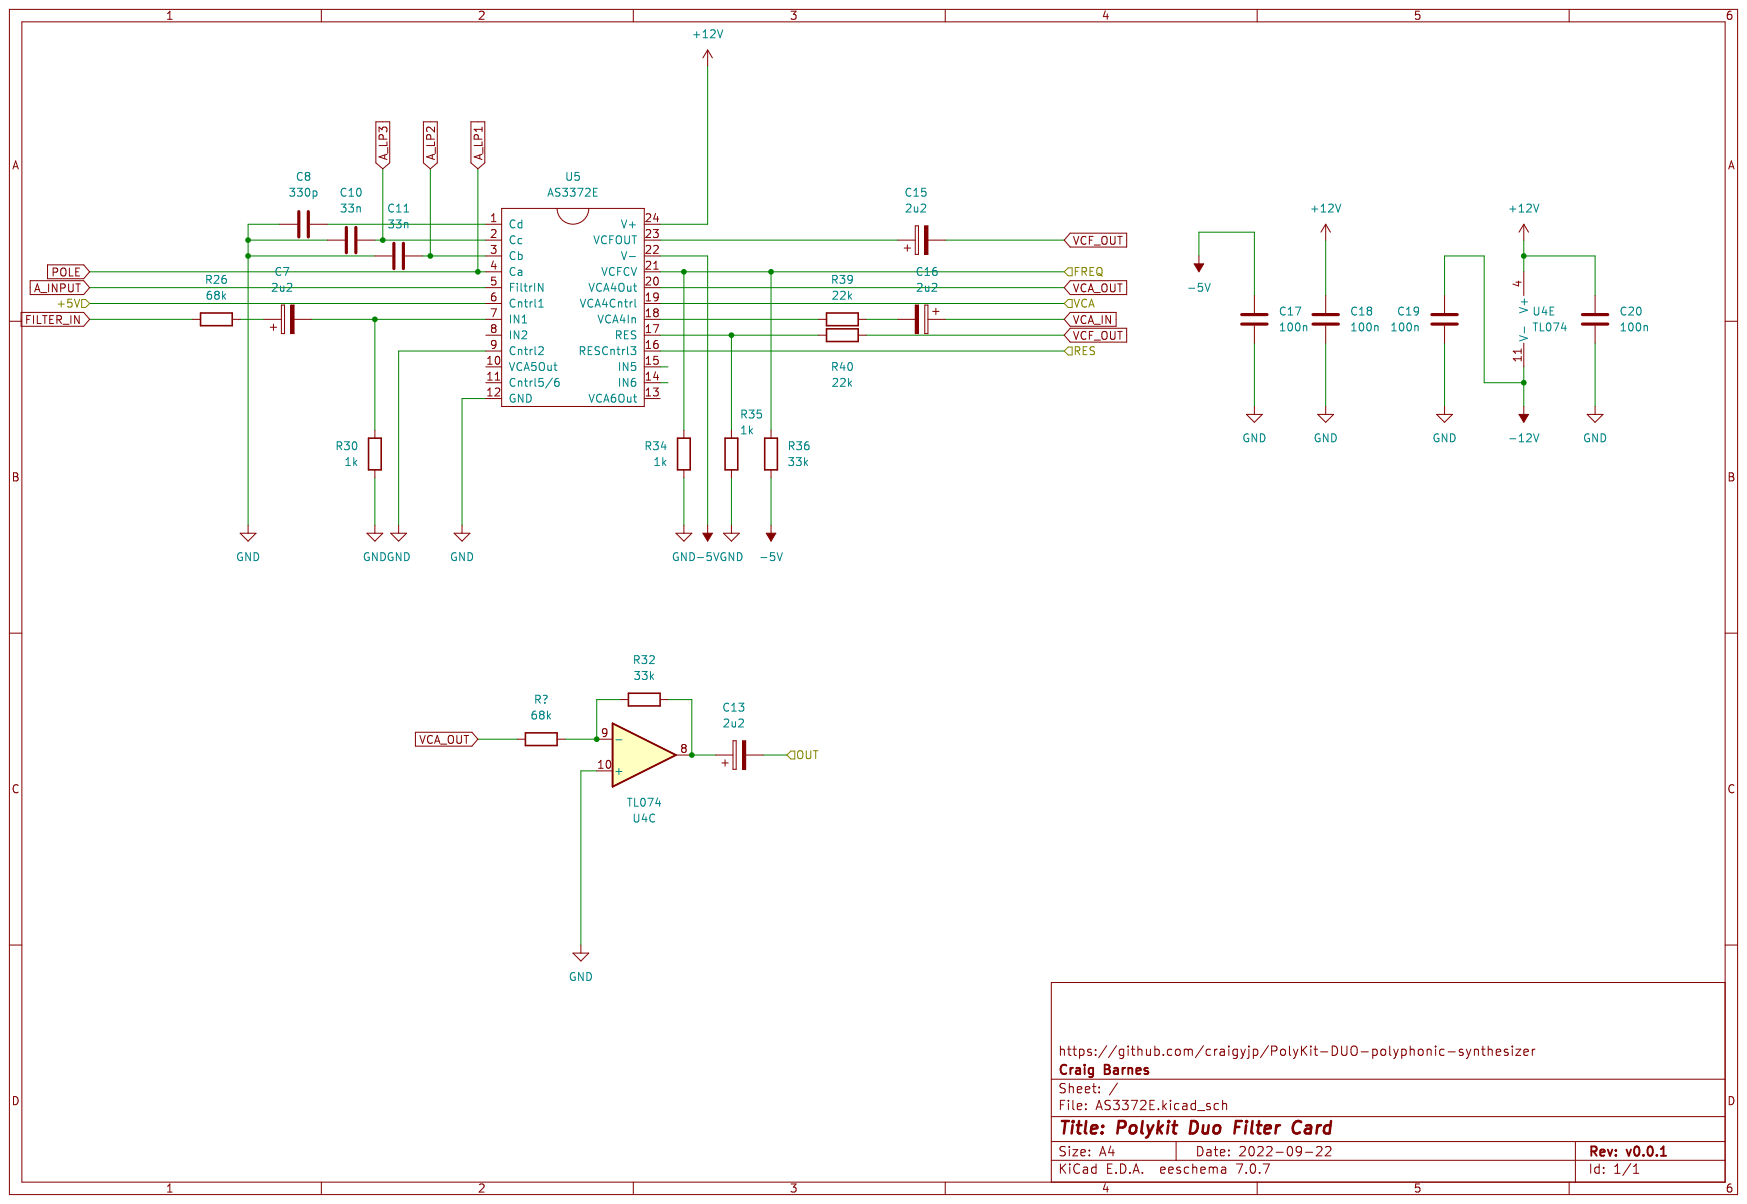
[picture p25: page 1]
