craigyjp/Poly-Zero-8-voice-Polysynth/Schematics/Filter_controld_and_EGs.pdf

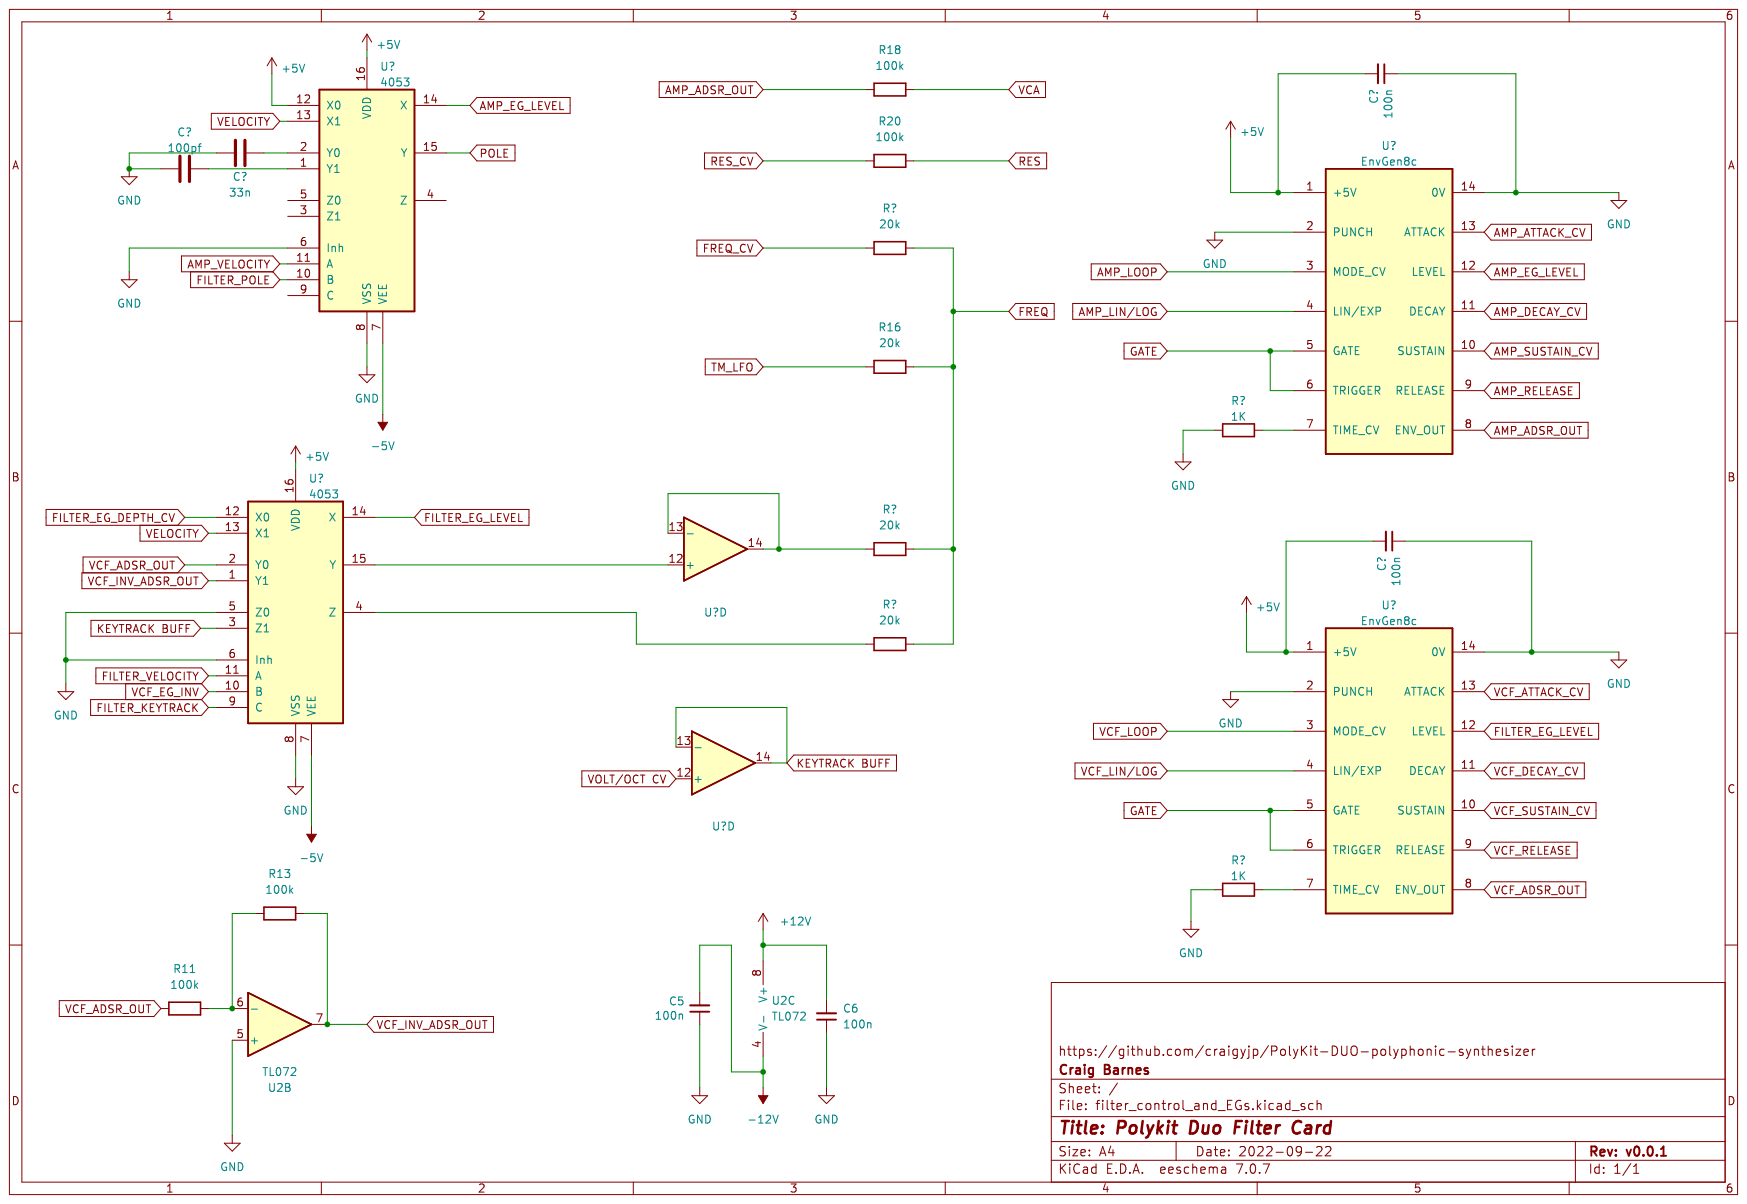
[picture p26: page 1]
