craigyjp/Poly-Zero-8-voice-Polysynth/Schematics/Filter_pole_mixer.pdf

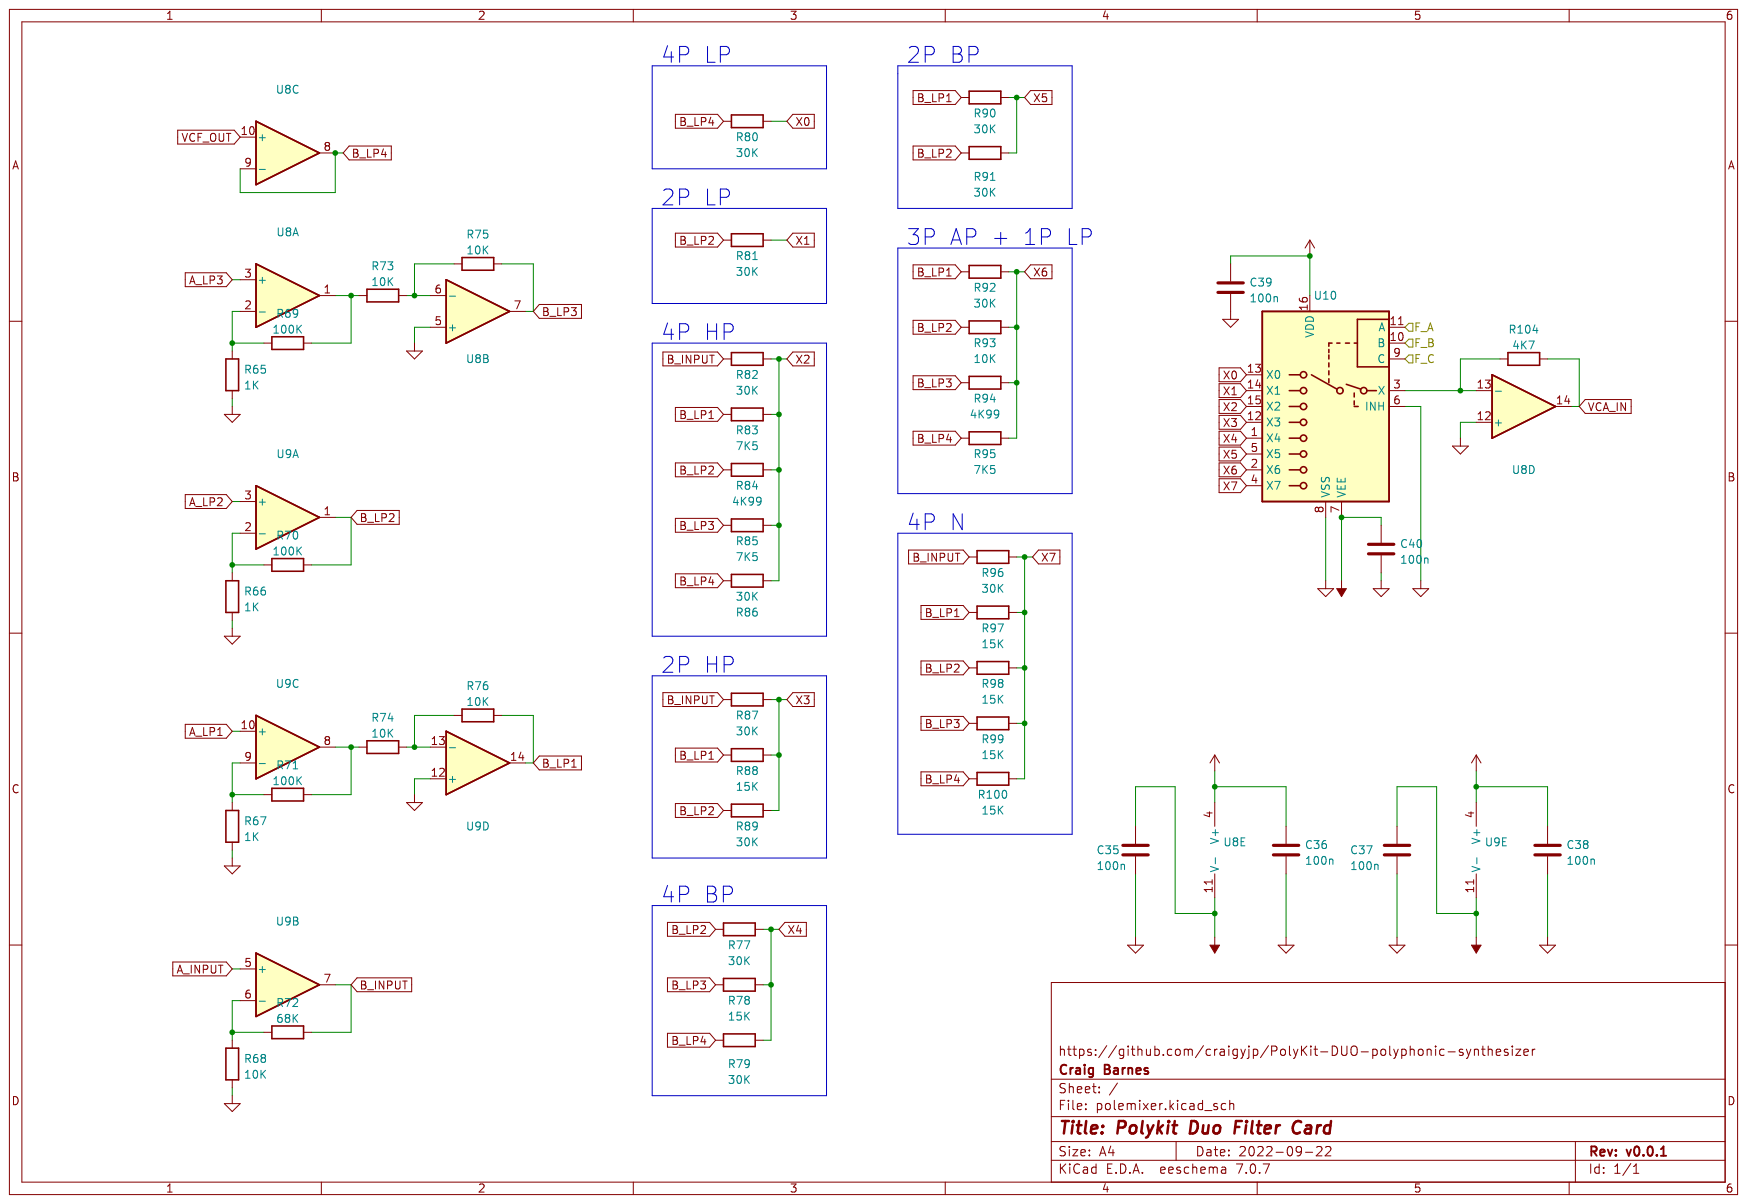
[picture p27: page 1]
