craigyjp/Poly-Zero-8-voice-Polysynth/Schematics/Filter_VCAs.pdf

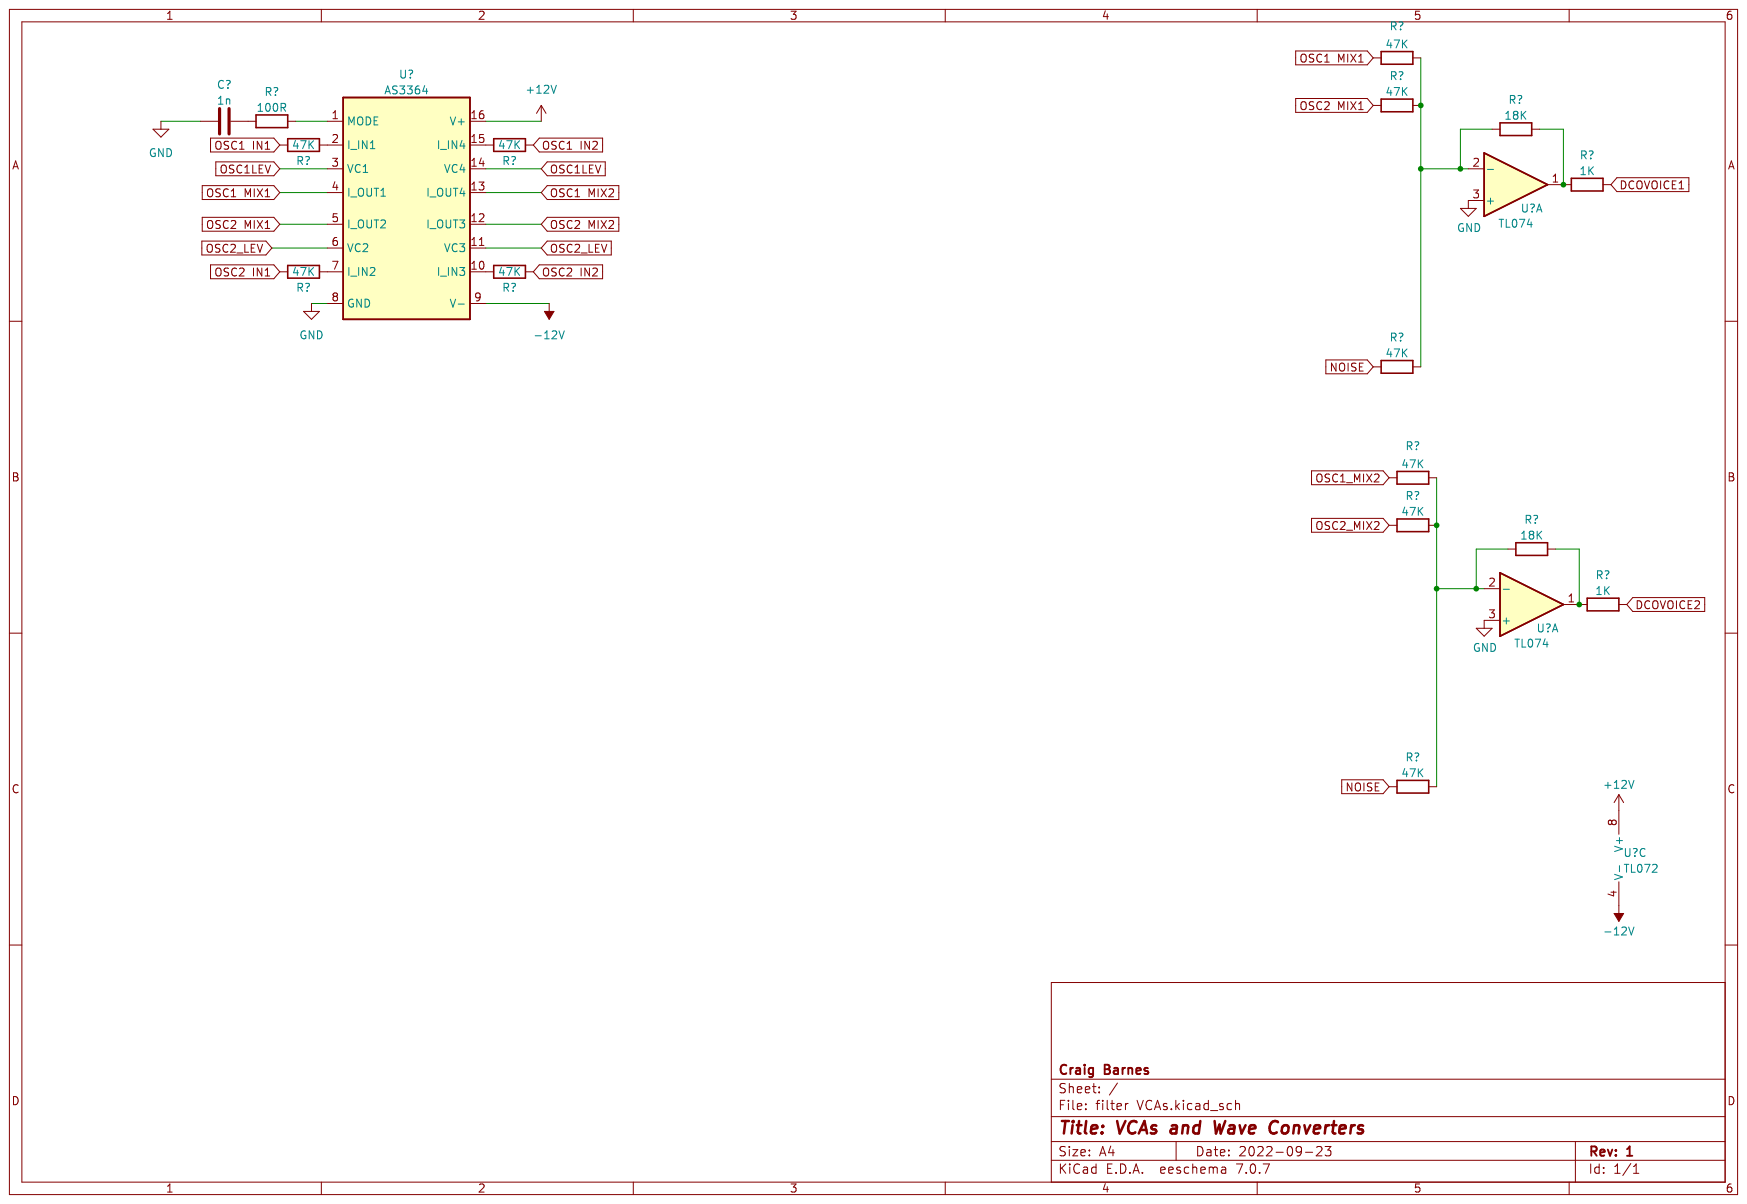
[picture p28: page 1]
