craigyjp/Poly-Zero-8-voice-Polysynth/Schematics/LFOs.pdf

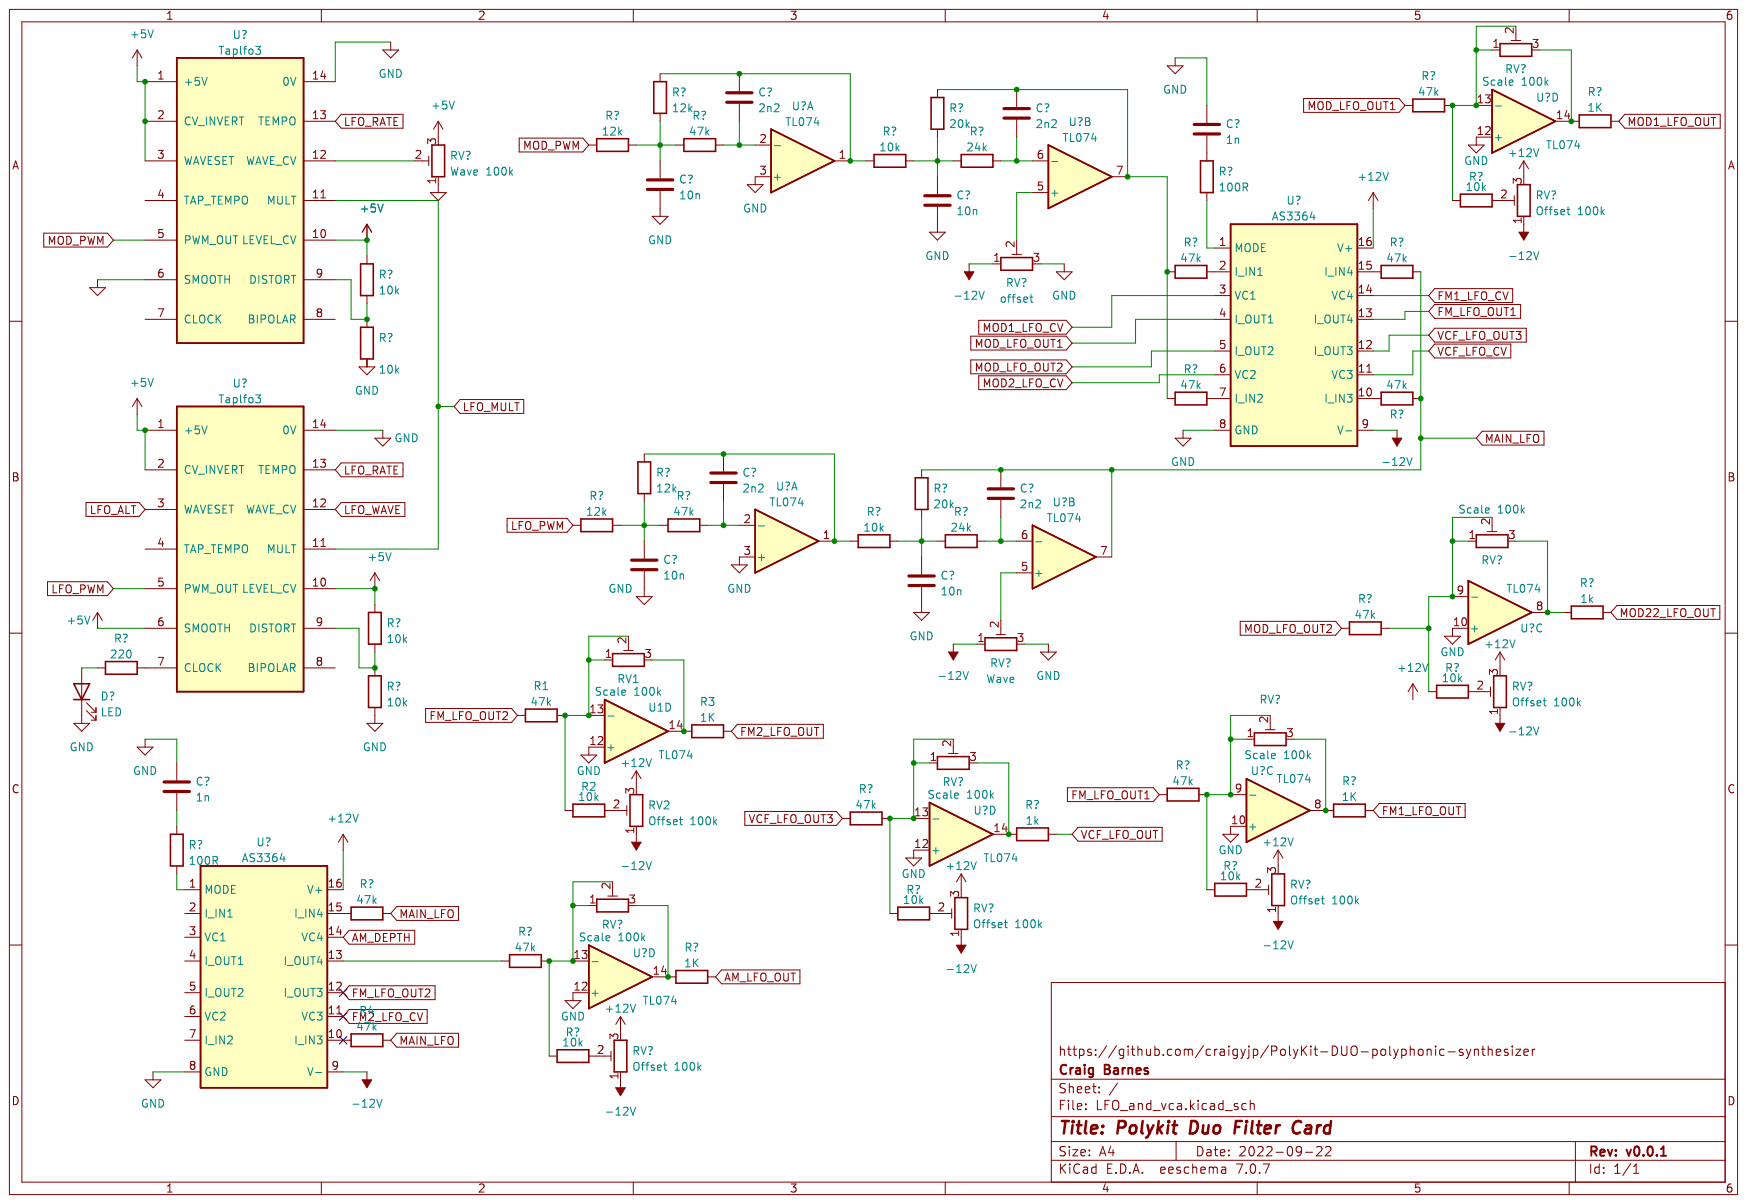
[picture p29: page 1]
