craigyjp/Poly-Zero-8-voice-Polysynth/Schematics/Teensy_Board.pdf

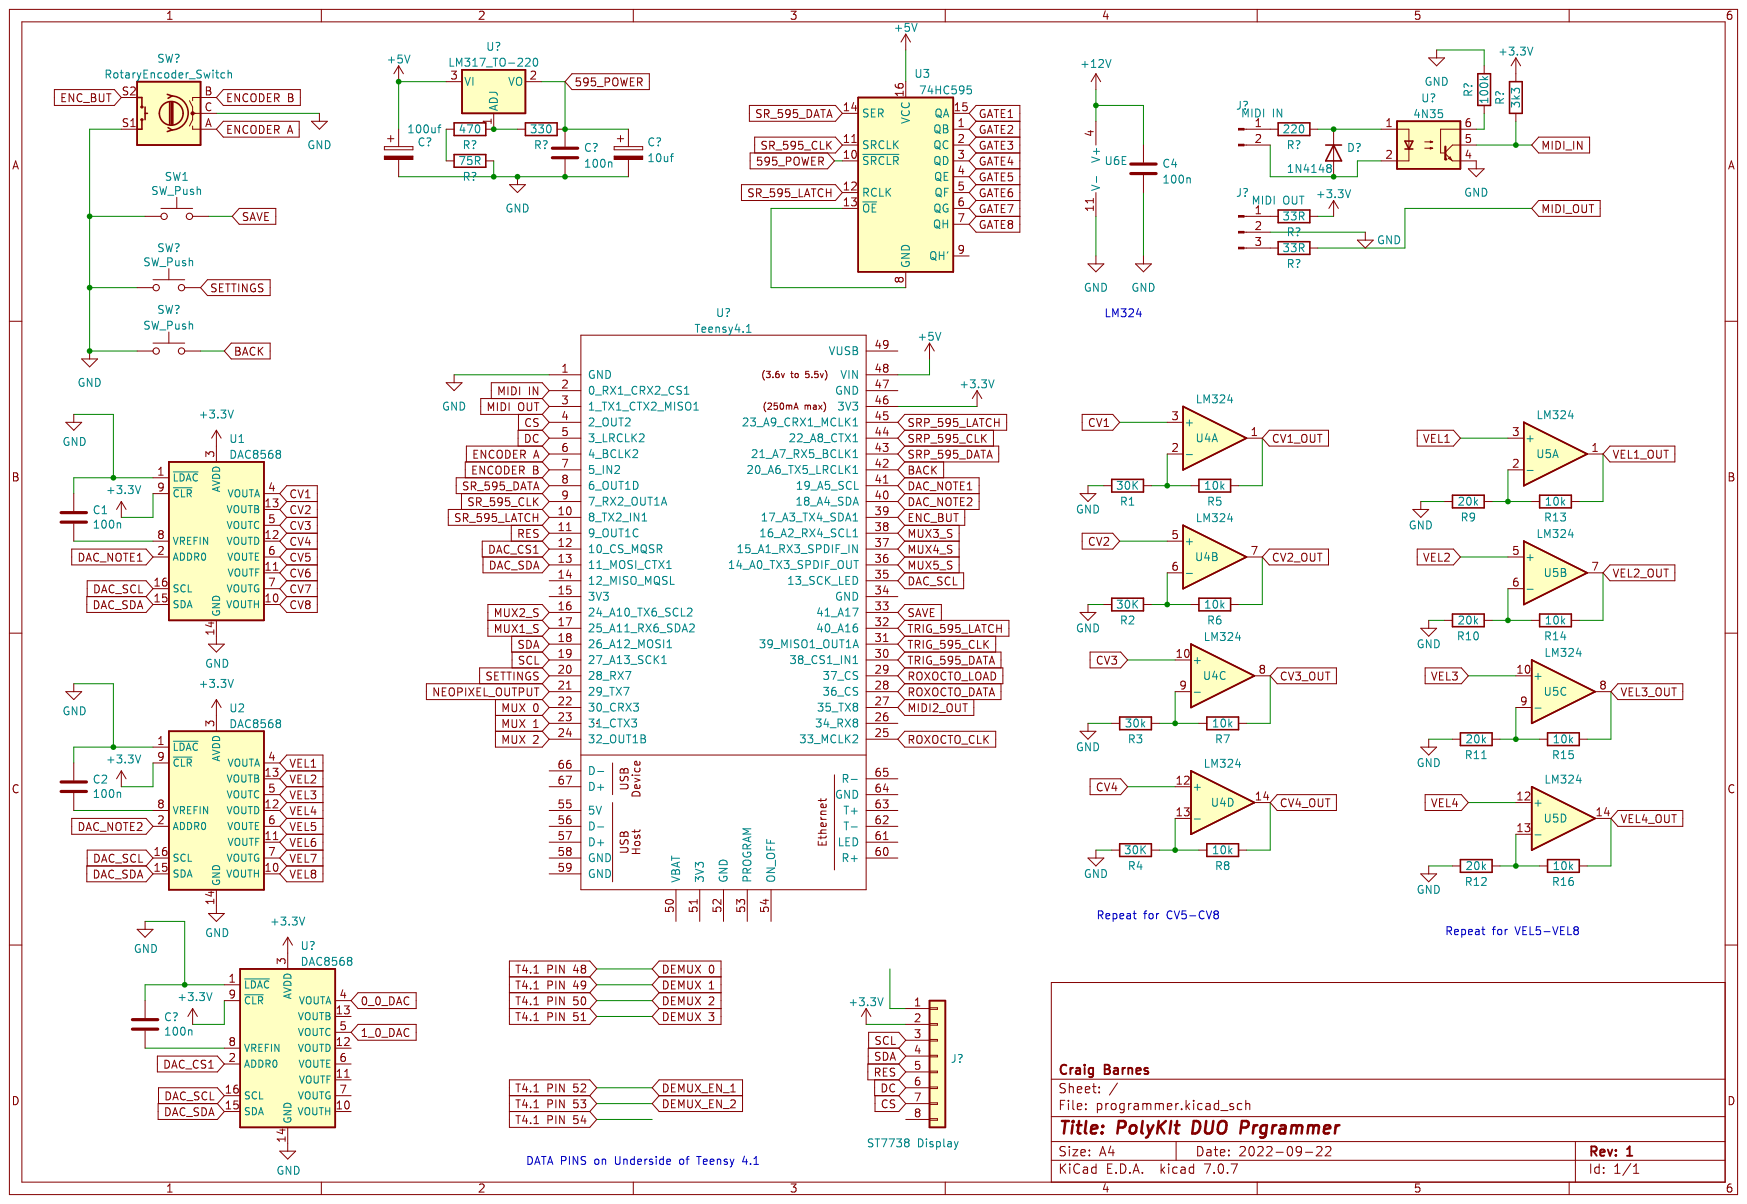
[picture p30: page 1]
