craigyjp/Poly-Zero-8-voice-Polysynth/ZeroDCOCode/Parameters.h

// Global variables for portamento
int prevNoteVal = 0;
float current_freq = 0;
float target_freq = 0;
float glide_rate = 0;
unsigned long lastGlideTime = 0;
const int minGlideTime = 0; // Minimum glide time in milliseconds
const int maxGlideTime = 4000; // Maximum glide time in milliseconds
float exponent = 2.0; // Change this value as needed
boolean osc2 = false;

int k = 1;
float AM_mod = 1;  //AM modulation rate
float f = 0;
int slice_num = 0;
float osc_freq = 0;
float mod = 0;
int wavetable[256];        //1024 resolution , 256 rate
float mod_wavetable[256];  //1st modulated wavetable
int mod2_wavetable[256];   //2nd modulated wavetable
float calb = 1.142;        //calibration for reduce resistance error
int freq_pot, fm_input, oct_sw, mode, pb_input;
int waveform = 0;

int f0 = 32;     //base osc frequency
long timer = 0;  //use for making AM sinewave
boolean glidesw = false;
int glidetime = 0;
int noteVal = 0;
int type, channel, d1, d2;

const static float voctpow[1230] = {
  //Covers 6(=1230) octaves. If it is 1230 or more, the operation becomes unstable.
  0,
  0.004882,
  0.009765,
  0.014648,
  0.019531,
  0.024414,
  0.029296,
  0.034179,
  0.039062,
  0.043945,
  0.048828,
  0.05371,
  0.058593,
  0.063476,
  0.068359,
  0.073242,
  0.078125,
  0.083007,
  0.08789,
  0.092773,
  0.097656,
  0.102539,
  0.107421,
  0.112304,
  0.117187,
  0.12207,
  0.126953,
  0.131835,
  0.136718,
  0.141601,
  0.146484,
  0.151367,
  0.15625,
  0.161132,
  0.166015,
  0.170898,
  0.175781,
  0.180664,
  0.185546,
  0.190429,
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
};

float freq_table[2048];
