craigyjp/Poly-Zero-8-voice-Polysynth/PolysynthCode/HWControls.h

// This optional setting causes Encoder to use more optimized code,
// It must be defined before Encoder.h is included.
#define ENCODER_OPTIMIZE_INTERRUPTS
#include <Encoder.h>
#include <Bounce.h>
#include "TButton.h"
#include <ADC.h>
#include <ADC_util.h>

ADC *adc = new ADC();

#define NEOPIXEL_OUTPUT 29

//Teensy 4.1 - Mux Pins
#define MUX_0 30
#define MUX_1 31
#define MUX_2 32

#define MUX1_S A11 // ADC0
#define MUX2_S A10 // ADC0
#define MUX3_S A2  // ADC1
#define MUX4_S A1  // ADC1
#define MUX5_S A0  // ADC1

#define DAC_CS1 10
#define DAC_NOTE1 19
#define DAC_NOTE2 18

#define DEMUX_0 48
#define DEMUX_1 49
#define DEMUX_2 50
#define DEMUX_3 51

#define DEMUX_EN_1 52
#define DEMUX_EN_2 53

//Note DAC
#define DACMULT 25.9
#define DACMULT2 22.9 // reduce 5v to 3.3v
#define DACMULT3 42.5 // increase 2v to 3.3v
#define MIDICCTOPOT 8.62

//Mux 1 Connections
#define MUX1_volumeControl 0
#define MUX1_ampAttack 1
#define MUX1_ampDecay 2
#define MUX1_spare3 3
#define MUX1_ampSustain 4
#define MUX1_effectMix 5
#define MUX1_ampRelease 6
#define MUX1_amDepth 7

//Mux 2 Connections
#define MUX2_filterSustain 0
#define MUX2_filterDecay 1
#define MUX2_filterAttack 2
#define MUX2_filterRelease 3
#define MUX2_Resonance 4
#define MUX2_keyTrack 5 // spare mux output - decouple from DAC
#define MUX2_filterEGlevel 6
#define MUX2_spare7 7 // spare mux output

//Mux 3 Connections
#define MUX3_spare0 0
#define MUX3_tmDepth 1
#define MUX3_filterCutoff 2
#define MUX3_spare3 3
#define MUX3_osc1Level 4
#define MUX3_spare5 5
#define MUX3_osc2Level 6
#define MUX3_effect3 7

//Mux 4 Connections
#define MUX4_spare0 0
#define MUX4_effect2 1
#define MUX4_osc2fmDepth 2
#define MUX4_spare3 3
#define MUX4_osc1fmDepth 4
#define MUX4_effect1 5
#define MUX4_osc1ModDepth 6
#define MUX4_osc2ModDepth 7

//Switches 
//Mux 5 Connections
#define MUX5_lfoDelay 0
#define MUX5_noiseLevel 1
#define MUX5_glideTime 2
#define MUX5_lfoRate 3
#define MUX5_osc1Freq 4
#define MUX5_osc2Mod 5 // spare mux output - decouple from DAC
#define MUX5_osc1Mod 6
#define MUX5_osc2Freq 7 // spare mux output

// Polykit 16 DEMUX card 595 outputs

#define FILTER_A 0
#define FILTER_B 1
#define FILTER_C 2
#define FILTER_POLE 3
#define FILTER_EG_INV 4
#define FILTER_VELOCITY 5
#define AMP_VELOCITY 6
#define LFO_ALT 7

#define SPARE_8 8 
#define SPARE_9 9
#define FLOOPBIT0 10
#define FLOOPBIT1 11
#define ALOOPBIT0 12
#define ALOOPBIT1 13
#define FILTER_LIN_LOG 14
#define AMP_LIN_LOG 15

#define EFFECT_0 16  // 3.3v
#define EFFECT_1 17  // 3.3v
#define EFFECT_2 18  // 3.3v
#define EFFECT_BANK 19  // 3.3v
#define FILTER_KEYTRACK 20
#define SPARE_21 21
#define EFFECT_ROM_0 22  // 3.3v
#define EFFECT_ROM_1 23  // 3.3v

// Panel Buttons
// 0
#define EFFECT_BANK_SW 0
#define FILTER_POLE_SW 1
#define FILTER_LOOP_SW 2
#define EG_INVERT_SW 3
#define FILTER_VELOCITY_SW 4
#define FILTER_TYPE_SW 5
#define LIN_LOG_SW 6
#define MONO_MULTI_SW 7
// 1
#define LFO_WAVE_SW 8
#define LFO_ALT_SW 9
#define LFO_MULT_SW 10
#define GLIDE_SW 11
#define VCA_GATE_SW 12
#define VCA_LOOP_SW 13
#define VCA_VELOCITY_SW 14
#define PRIORITY_SW 15
// 2
#define DCO1_OCT_SW 16
#define DCO1_MODE_SW 17
#define DCO1_WAVE_SW 18
#define DCO2_OCT_SW 19
#define DCO2_MODE_SW 20
#define DCO2_WAVE_SW 21
#define POLYMODE_SW 22

// Panel LEDS
// 0
#define FILTER_VELOCITY_LED 0
#define EG_INV_LED 1
#define FILTER_LOOP_GREEN_LED 2
#define FILTER_LOOP_RED_LED 3
#define FILTER_POLE_GREEN_LED 4
#define FILTER_POLE_RED_LED 5
#define EFFECT_BANK_GREEN_LED 6
#define EFFECT_BANK_RED_LED 7

//1
#define VCA_VELOCITY_LED 8
#define VCA_LOOP_GREEN_LED 9
#define VCA_LOOP_RED_LED 10
#define VCA_GATE_LED 11
#define GLIDE_LED 12
#define LIN_LOG_GREEN_LED 13
#define LIN_LOG_RED_LED 14
#define MONO_MULTI_LED 15

//2
#define LFO_MULT_GREEN_LED 16
#define LFO_MULT_RED_LED 17
#define LFO_ALT_GREEN_LED 18
#define LFO_ALT_RED_LED 19
#define PRIORITY_GREEN_LED 20
#define PRIORITY_RED_LED 21
#define POLY_MODE_GREEN_LED 22
#define POLY_MODE_RED_LED 23

//3
#define DCO1_MODE_GREEN_LED 24
#define DCO1_MODE_RED_LED 25
#define DCO2_MODE_GREEN_LED 26
#define DCO2_MODE_RED_LED 27
#define DCO1_OCT_GREEN_LED 28
#define DCO1_OCT_RED_LED 29
#define DCO2_OCT_GREEN_LED 30
#define DCO2_OCT_RED_LED 31

#define GATE_NOTE1 0
#define GATE_NOTE2 1
#define GATE_NOTE3 2
#define GATE_NOTE4 3
#define GATE_NOTE5 4
#define GATE_NOTE6 5
#define GATE_NOTE7 6
#define GATE_NOTE8 7


//Teensy 4.1 Pins

#define RECALL_SW 17
#define SAVE_SW 41
#define SETTINGS_SW 28
#define BACK_SW 20

#define ENCODER_PINA 4
#define ENCODER_PINB 5

#define MUXCHANNELS 8
#define DEMUXCHANNELS 16
#define QUANTISE_FACTOR 10

#define DEBOUNCE 30

static byte muxInput = 0;
static byte muxOutput = 0;

static int mux1ValuesPrev[MUXCHANNELS] = {};
static int mux2ValuesPrev[MUXCHANNELS] = {};
static int mux3ValuesPrev[MUXCHANNELS] = {};
static int mux4ValuesPrev[MUXCHANNELS] = {};
static int mux5ValuesPrev[MUXCHANNELS] = {};

static int mux1Read = 0;
static int mux2Read = 0;
static int mux3Read = 0;
static int mux4Read = 0;
static int mux5Read = 0;
static int mux1ReadMIDI = 0;
static int mux2ReadMIDI = 0;
static int mux3ReadMIDI = 0;
static int mux4ReadMIDI = 0;
static int mux5ReadMIDI = 0;

static long encPrevious = 0;

//These are pushbuttons and require debouncing

TButton saveButton{ SAVE_SW, LOW, HOLD_DURATION, DEBOUNCE, CLICK_DURATION };
TButton settingsButton{ SETTINGS_SW, LOW, HOLD_DURATION, DEBOUNCE, CLICK_DURATION };
TButton backButton{ BACK_SW, LOW, HOLD_DURATION, DEBOUNCE, CLICK_DURATION };
TButton recallButton{ RECALL_SW, LOW, HOLD_DURATION, DEBOUNCE, CLICK_DURATION };  //On encoder

Encoder encoder(ENCODER_PINB, ENCODER_PINA);  //This often needs the pins swapping depending on the encoder

void setupHardware() {

  adc->adc0->setAveraging(16); // set number of averages 0, 4, 8, 16 or 32.
  adc->adc0->setResolution(10); // set bits of resolution  8, 10, 12 or 16 bits.
  adc->adc0->setConversionSpeed(ADC_CONVERSION_SPEED::VERY_LOW_SPEED); // change the conversion speed
  adc->adc0->setSamplingSpeed(ADC_SAMPLING_SPEED::MED_SPEED); // change the sampling speed

  //MUXs on ADC1
  adc->adc1->setAveraging(16); // set number of averages 0, 4, 8, 16 or 32.
  adc->adc1->setResolution(10); // set bits of resolution  8, 10, 12 or 16 bits.
  adc->adc1->setConversionSpeed(ADC_CONVERSION_SPEED::VERY_LOW_SPEED); // change the conversion speed
  adc->adc1->setSamplingSpeed(ADC_SAMPLING_SPEED::MED_SPEED); // change the sampling speed

  analogReadResolution(10);
  //Mux address pins

  pinMode(MUX_0, OUTPUT);
  pinMode(MUX_1, OUTPUT);
  pinMode(MUX_2, OUTPUT);

  digitalWrite(MUX_0, LOW);
  digitalWrite(MUX_1, LOW);
  digitalWrite(MUX_2, LOW);

  pinMode(DAC_CS1, OUTPUT);
  digitalWrite(DAC_CS1, HIGH);
  pinMode(DAC_NOTE1, OUTPUT);
  digitalWrite(DAC_NOTE1, HIGH);
  pinMode(DAC_NOTE2, OUTPUT);
  digitalWrite(DAC_NOTE2, HIGH);

  pinMode(DEMUX_0, OUTPUT);
  pinMode(DEMUX_1, OUTPUT);
  pinMode(DEMUX_2, OUTPUT);
  pinMode(DEMUX_3, OUTPUT);

  pinMode(DEMUX_EN_1, OUTPUT);
  pinMode(DEMUX_EN_2, OUTPUT);

  digitalWrite(MUX_0, LOW);
  digitalWrite(MUX_1, LOW);
  digitalWrite(MUX_2, LOW);

  digitalWrite(DEMUX_0, LOW);
  digitalWrite(DEMUX_1, LOW);
  digitalWrite(DEMUX_2, LOW);
  digitalWrite(DEMUX_0, LOW);

  digitalWrite(DEMUX_EN_1, HIGH);
  digitalWrite(DEMUX_EN_1, HIGH);

  //Mux ADC
  pinMode(MUX1_S, INPUT_DISABLE);
  pinMode(MUX2_S, INPUT_DISABLE);
  pinMode(MUX3_S, INPUT_DISABLE);
  pinMode(MUX4_S, INPUT_DISABLE);
  pinMode(MUX5_S, INPUT_DISABLE);

  //Switches
  pinMode(RECALL_SW, INPUT_PULLUP);  //On encoder
  pinMode(SAVE_SW, INPUT_PULLUP);
  pinMode(SETTINGS_SW, INPUT_PULLUP);
  pinMode(BACK_SW, INPUT_PULLUP);

  SPI.beginTransaction(SPISettings(20000000, MSBFIRST, SPI_MODE1));
  digitalWrite(DAC_CS1, LOW);
  SPI.transfer32(int_ref_on_flexible_mode);
  delayMicroseconds(1);
  digitalWrite(DAC_CS1, HIGH);
  SPI.endTransaction();

  SPI.beginTransaction(SPISettings(20000000, MSBFIRST, SPI_MODE1));
  digitalWrite(DAC_NOTE1, LOW);
  SPI.transfer32(int_ref_on_flexible_mode);
  delayMicroseconds(1);
  digitalWrite(DAC_NOTE1, HIGH);
  SPI.endTransaction();

  SPI.beginTransaction(SPISettings(20000000, MSBFIRST, SPI_MODE1));
  digitalWrite(DAC_NOTE2, LOW);
  SPI.transfer32(int_ref_on_flexible_mode);
  delayMicroseconds(1);
  digitalWrite(DAC_NOTE2, HIGH);
  SPI.endTransaction();

}
