craigyjp/Poly-Zero-8-voice-Polysynth/PolysynthCode/Constants.h

const char* VERSION = "V1.3";
const char* str_ptr = nullptr;
const float FILTERCUTOFF[128] = {20, 23, 26, 29, 32, 36, 40, 46, 53, 60, 69, 78, 87, 98, 109, 120, 132, 145, 157, 171, 186, 200, 215, 231, 247, 264, 282, 300, 319, 338, 357, 378, 399, 421, 444, 467, 491, 516, 541, 567, 594, 621, 650, 680, 710, 741, 774, 806, 841, 876, 912, 949, 987, 1027, 1068, 1110, 1152, 1196, 1242, 1290, 1338, 1388, 1439, 1491, 1547, 1603, 1661, 1723, 1783, 1843, 1915, 1975, 2047, 2119, 2191, 2263, 2347, 2419, 2503, 2587, 2683, 2767, 2863, 2959, 3055, 3163, 3259, 3367, 3487, 3595, 3715, 3835, 3967, 4099, 4231, 4363, 4507, 4663, 4807, 4963, 5131, 5287, 5467, 5635, 5815, 6007, 6199, 6403, 6607, 6823, 7039, 7267, 7495, 7735, 7987, 8239, 8503, 8779, 9055, 9343, 9643, 9955, 10267, 10603, 10939, 11287, 11647, 12000};
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
const int LINEAR_NEGATIVE[128] = {0, -1, -2, -2, -3, -4, 5, 6, 6, 7, 8, 9, 9, 10, 11, 12, 13, 13, 14, 15, 16, 17, 17, 18, 19, 20, 20, 21, 22, 23, 24, 24, 25, 26, 27, 28, 28, 29, 30, 31, 31, 32, 33, 34, 35, 35, 36, 37, 38, 39, 39, 40, 41, 42, 43, 43, 44, 45, 46, 46, 47, 48, 49, 50, 50, 51, 52, 53, 54, 54, 55, 56, 57, 57, 58, 59, 60, 61, 61, 62, 63, 64, 65, 65, 66, 67, 68, 69, 69, 70, 71, 72, 72, 73, 74, 75, 76, 76, 77, 78, 79, 80, 80, 81, 82, 83, 83, 84, 85, 86, 87, 87, 88, 89, 90, 91, 91, 92, 93, 94, 94, 95, 96, 97, 98, 99, 100, 100};
#define RE_READ -9

#define NO_OF_PARAMS 150
const char* INITPATCHNAME = "Initial Patch";
#define HOLD_DURATION 1000
const uint32_t CLICK_DURATION = 250;
#define PATCHES_LIMIT 999
const String INITPATCH = "CC Mode,1,1,1,1,1,1,1,1,1,1,1,1,1,1,1,1,1,1,1,1,1,1,1,1,1,1,1,1,1,1,1,1,1,1,1,1,1,1,1,1,1,1,1,1,1,1,1,1,1,1,1,1,1,1,1,1,1,1,1,1,1,1,1,1,1,1,1,1,1,1,1,1,1,1,1,1,1,1,1,1,1,1,1,1,1,1,1,1,1,1,1,1,1,1,1,1,1,1,1,1,1,1,1,1,1,1,1,1,1,1,1,1,1,1,1,1,1,1,1";
