craigyjp/Poly-Zero-8-voice-Polysynth/PolysynthCode/ScreenParams.h

//PRESET 1st line
const char str01[8][14] PROGMEM = {//str1 is effect name of 1st line
 "Chorus", "Flange", "Tremolo", "Pitch", "Pitch", "No Effect", "Reverb", "Reverb"
};
const char* const name01[] PROGMEM = {
 str01[0], str01[1], str01[2], str01[3], str01[4], str01[5], str01[6], str01[7],
};

//PRESET 2nd line
const char str02[8][14] PROGMEM = {//str1 is effect name of 1st line
 "Reverb", "Reverb", "Reverb", "Shift", "Echo", " ", "1", "2"
};
const char* const name02[] PROGMEM = {
 str02[0], str02[1], str02[2], str02[3], str02[4], str02[5], str02[6], str02[7],
};

//PRESET param1
const char str03[8][14] PROGMEM = {//str1 is effect name of 1st line
 "Reverb Mix", "Reverb Mix", "Reverb Mix", "Pitch", "Pitch", "-", "Reverb Time", "Reverb Time"
};
const char* const name03[] PROGMEM = {
 str03[0], str03[1], str03[2], str03[3], str03[4], str03[5], str03[6], str03[7],
};

//PRESET param2
const char str04[8][14] PROGMEM = {//str1 is effect name of 1st line
 "Chorus Rate", "Flanger Rate", "Tremelo Rate", "-", "Echo Delay", "-", "HF Filter", "HF Filter"
};
const char* const name04[] PROGMEM = {
 str04[0], str04[1], str04[2], str04[3], str04[4], str04[5], str04[6], str04[7],
};

//PRESET param3
const char str05[8][14] PROGMEM = {//str1 is effect name of 1st line
 "Chorus Mix", "Flanger Mix", "Tremelo Mix", "-", "Echo Mix", "-", "LF Filter", "LF Filter"
};
const char* const name05[] PROGMEM = {
 str05[0], str05[1], str05[2], str05[3], str05[4], str05[5], str05[6], str05[7],
};

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
};

//ROM3 param3
const char str35[8][14] PROGMEM = {//str1 is effect name of 1st line
"Feedback","Feedback","Ensemble","Speed","Speed","Treble","Speed","Sensitivity"
};
const char* const name35[] PROGMEM = {
 str35[0], str35[1], str35[2], str35[3], str35[4], str35[5], str35[6], str35[7],
};

//filter01
const char str40[8][14] PROGMEM = {//str1 is effect name of 1st line
"4P LowPass","2P LowPass","4P HighPass","2P HighPass","4P BandPass","2P BandPass","3P AllPass","Notch"
};
const char* const filter02[] PROGMEM = {
 str40[0], str40[1], str40[2], str40[3], str40[4], str40[5], str40[6], str40[7],
};

//filter02
const char str41[8][14] PROGMEM = {//str1 is effect name of 1st line
"3P LowPass","1P LowPass","3P HP + 1P LP","1P HP + 1P LP","2P HP + 1P LP","2P BP + 1P LP","3P AP + 1P LP","2P Notch + LP"
};
const char* const filter01[] PROGMEM = {
 str41[0], str41[1], str41[2], str41[3], str41[4], str41[5], str41[6], str41[7],
};

//lfo01
const char str42[8][14] PROGMEM = {//str1 is effect name of 1st line
"Sawtooth Up","Sawtooth Dn","Square","Triangle","Sine","Sweep","Lumps","Random"
};
const char* const lfo01[] PROGMEM = {
 str42[0], str42[1], str42[2], str42[3], str42[4], str42[5], str42[6], str42[7],
};

//lfo02
const char str43[8][14] PROGMEM = {//str1 is effect name of 1st line
"Saw + Octave","Quad Saw","Quad Pulse","Tri Step","Sine + Octave","Sine + 3rd","Sine + 4th","Slopes"
};
const char* const lfo02[] PROGMEM = {
 str43[0], str43[1], str43[2], str43[3], str43[4], str43[5], str43[6], str43[7],
};

//vco01
const char str44[8][14] PROGMEM = {
"Sawtooth","Sinewave","Squarewave","Triangle","Octave Saw","FM 1","FM2 ","FM3"
};
const char* const vco01[] PROGMEM = {
 str44[0], str44[1], str44[2], str44[3], str44[4], str44[5], str44[6], str44[7],
};

//vco02
const char str45[8][14] PROGMEM = {//str1 is effect name of 1st line
"FM 1","FM 2","FM 3","FM 4","FM 5","FM 6","FM 7","FM 8"
};
const char* const vco02[] PROGMEM = {
 str45[0], str45[1], str45[2], str45[3], str45[4], str45[5], str45[6], str45[7],
};

//vco02
const char str46[8][14] PROGMEM = {//str1 is effect name of 1st line
"Sawtooth","FM 1","FM 2","FM 3","FM 1 Multi","FM 2 Multi","FM 3 Multi","FM 4 Multi"
};
const char* const vco03[] PROGMEM = {
 str46[0], str46[1], str46[2], str46[3], str46[4], str46[5], str46[6], str46[7],
};
