craigyjp/Poly-Zero-8-voice-Polysynth/(commit log)

2024-03-19 Updated functions of buttons, pots etc, stabilized tuning
    [HWControls.h, MidiCC.h, Parameters.h, Poly_Zero.ino]
2024-03-19 Fixed note priority on Keystep
    [Poly_Zero.ino]
2024-03-20 Added Teensy and DCO board
2024-03-20 Added modded LFO boards
2024-03-20 Added FX board
2024-03-29 Created center points for effects mix, noise etc
    [ST7735Display.h]
2024-03-29 Fixed Modwheel & depth over MIDI
    [EepromMgr.h, Poly_Zero.ino, Settings.h, SettingsService.h]
2024-03-30 Fixed clash between delayed LFO and AfterTouch
    [Constants.h, EepromMgr.h, Parameters.h, Poly_Zero.ino, Settings.h]
2024-03-30 Fixed bug in delayed LFO and aftertouch
    [Poly_Zero.ino]
2024-04-01 Updated effects board with eeprom selection
2024-04-08 Fixed Pixel LEDs afetr RGB to GRB swap screwed up colours
    [Poly_Zero.ino, ST7735Display.h]
2024-04-08 Fixed remaining menus for display size.
    [ST7735Display.h]
2024-04-08 Switch effect to first position on bank change
2024-04-08 Fixed gnd pin for DCO2
2024-04-08 Fixed pitchbend range to 6 semitones
    [Poly_Zero.ino, Settings.h]
2024-05-11 Improved handling of the aftertouch to filter cutoff
